jakoai/Riistvara-projekt/components.xlsx

 | link | hind | kogus |  | kokku | 96.39395 | tellitud | 3v3 power max | 0.824717
NFC | https://www.mouser.ee/ProductDetail/STMicroelectronics/ST25DV04KC-IE8T3?qs=QNEnbhJQKvb3R1XQucBykQ%3D%3D | 1.43 | 1 | 1.43 |  |  | 5
GPS | https://www.mouser.ee/ProductDetail/Quectel/L96-M33?qs=GedFDFLaBXHZlDfU1tecmQ%3D%3D | 14.15 | 1 | 14.15 |  |  | 5 | 0.025
IMU | https://www.mouser.ee/ProductDetail/MEMSIC/MC3479 | 1.89 | 1 | 1.89 |  |  | 5 | 7.7e-05
E-ink | https://www.mouser.ee/ProductDetail/Pervasive-Displays/E2266CS0C2?qs=TuK3vfAjtkUnQD9wfVPXWg%3D%3D | 10.98 | 1 | 10.98 |  |  | 5 | 0.00294
ESP32-S3 N16R8 | https://www.mouser.ee/ProductDetail/Espressif-Systems/ESP32-S3-WROOM-1-N16R8 | 4.31 | 1 | 4.31 |  |  | 5 | 0.5
LoRa Ra-01SH | https://www.aliexpress.com/item/4001148156263.html | 4.82 | 1 | 4.82 |  |  | 5 | 0.14
LoRa antenn | https://www.mouser.ee/ProductDetail/Linx-Technologies/ANT-868-HESM?qs=hWgE7mdIu5TTyqPbNERfhg%3D%3D | 1.24 | 1 | 1.24 |  |  | 5
FPC display conn | https://www.mouser.ee/ProductDetail/GCT/FFC2B35-24-T?qs=Li%252BoUPsLEnvLbIbV0OhDVA%3D%3D | 0.47 | 1 | 0.47 |  |  | 5
USB-PD battery | https://www.mouser.ee/ProductDetail/Texas-Instruments/BQ25731RSNR?qs=stqOd1AaK7%2Fv1jry38xYIQ%3D%3D | 3.79 | 1 | 3.79 |  |  | 5
USB-C | https://www.mouser.ee/ProductDetail/TE-Connectivity/2305018-2?qs=EU6FO9ffTwfL23TDwkN0SQ%3D%3D | 2.55 | 2 | 5.1 |  |  | 10 |  |  | https://www.aliexpress.com/item/1005003210911840.html
USB-C protector | https://www.mouser.ee/ProductDetail/Texas-Instruments/TPD6S300ARUKR?qs=%252BEew9%252B0nqrA1G22imPqdyw%3D%3D | 1.3 | 2 | 2.6 |  |  | 10
Buzzer | https://www.mouser.ee/ProductDetail/AATC/AS-1204B-LF?qs=uwxL4vQweFPVV%2FkgmXOg0A%3D%3D | 0.64 | 1 | 0.64 |  |  | 5 | 0.035
SD card holder | https://www.aliexpress.com/item/1005004214252441.html | 0.59 | 1 | 0.59 |  |  | 10 | 0.04
RGB LED | https://www.aliexpress.com/item/32453497583.html | 0.0986 | 12 | 1.1832 |  |  | 100
serial to parralel | https://www.mouser.ee/ProductDetail/Nexperia/74HC595PW-Q100118?qs=1sbE9T7hb3aHrTORCcEuDg%3D%3D | 0.43 | 1 | 0.43 |  |  | 5
parrallel to serial | https://www.mouser.ee/ProductDetail/Texas-Instruments/SN74HCS16507PWR?qs=DPoM0jnrROUIT0uZVZ3kvw%3D%3D | 0.43 | 1 | 0.43 |  |  | 5
USB - UART | https://www.mouser.ee/ProductDetail/Silicon-Labs/CP2102N-A02-GQFN20?qs=u16ybLDytRaG8WdlP0fT2g%3D%3D | 2.16 | 1 | 2.16 |  |  | 5 | 0.0137
USB-PD negotiation | https://www.mouser.ee/ProductDetail/Texas-Instruments/TPS65988DKRSHR?qs=DPoM0jnrROUevQj%2FLwa4Vw%3D%3D | 6.64 | 1 | 6.64 |  |  | 5 | 0.008
DUAL NMOS 35A | https://www.mouser.ee/ProductDetail/Diodes-Incorporated/DMT3006LPB-13?qs=gZXFycFWdAPqLlAKkipM0Q%3D%3D | 0.72 | 2 | 1.44 |  |  | 10
Bat to 5V | https://www.mouser.ee/ProductDetail/Monolithic-Power-Systems-MPS/MP28167GQ-P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 | 3.18 | 1 | 3.18 |  |  | 5
Bat to USB-c | https://www.mouser.ee/ProductDetail/Monolithic-Power-Systems-MPS/MP2229GQ-P?qs=ZNK0BnemlqHKDD1LC56W1w%3D%3D | 2.84 | 2 | 5.68 |  |  | 10
Bat balancer | https://www.mouser.ee/ProductDetail/Texas-Instruments/BQ29209DRBR?qs=hEBn5lgDlCoqdeLwAzko8w%3D%3D | 0.96 | 1 | 0.96 |  |  | 5
Op amp | https://www.mouser.ee/ProductDetail/Texas-Instruments/LM358DR?qs=Zu35EjizYSSY6pJ37yjmHA%3D%3D | 0.37 | 0 | 0
Proximity card | https://www.aliexpress.com/item/33016782798.html | 0.239 | 2 | 0.478 |  |  | 10
Audio connector | https://www.mouser.ee/ProductDetail/CUI-Devices/SJ-3554A-SMT-TR-67?qs=l7cgNqFNU1hER9nK1Mk0ng%3D%3D | 3.45 | 0 | 0
Audio DAC | https://www.mouser.ee/ProductDetail/Texas-Instruments/PCM5100APWR?qs=E2%2FxqS9xjzplp26RZOMMKQ%3D%3D | 2.84 | 0 | 0 |  |  |  | 0.06
DUAL PMOS 6.9A | https://www.mouser.ee/ProductDetail/Diodes-Incorporated/DMP3056LSD-13?qs=oUsD4qhOtFx5gfG3AxMf9Q%3D%3D | 0.75 | 2 | 1.5 |  |  | 10
display schottky | https://www.mouser.ee/ProductDetail/Toshiba/CUHS20S30H3F?qs=PqoDHHvF64%252BnIC9Qnnw9zg%3D%3D | 0.38 | 3 | 1.14 |  |  | 15
nmos 5A | https://www.mouser.ee/ProductDetail/Panjit/PJA3404_R1_00001?qs=sPbYRqrBIVkiUO9ZInE3tw%3D%3D | 0.37 | 6 | 2.22 |  |  | 30
Fuse 20A | https://www.tme.eu/ee/details/zgs-20a/sulavkaitsmed-6-3x32mm-kiired/siba/189000-20/ | 0.2678 | 1 | 0.2678
JST XH 3p | https://www.aliexpress.com/item/1005003559631954.html | 0.0222 | 1 | 0.0222
Fuse holder | https://www.tme.eu/ee/details/01000020z/pcb-kaitsmepesad/littelfuse/ | 0.385 | 2 | 0.77
Resistor 5mO | https://www.mouser.ee/ProductDetail/Vishay/WFCP06125L000FE66?qs=sGAEpiMZZMtlubZbdhIBIJBDgjsVQBFlUYEtiJor9t8%3D | 0.29 | 2 | 0.58 |  |  | 10
Inductor Bat cntr | https://www.mouser.ee/ProductDetail/Bourns/SRP1265C-4R7M?qs=OlC7AqGiEDkg4Xkb2TDlFw%3D%3D | 1.5 | 1 | 1.5 |  |  | 5
Inductor 5V | https://www.mouser.ee/ProductDetail/Walsin/WLPMA0A040M4R7LC?qs=B6kkDfuK7%2FAGhXqtZ1HOFg%3D%3D | 0.67 | 1 | 0.67 |  |  | 5
Inductor USB source | https://www.mouser.ee/ProductDetail/Taiyo-Yuden/NRS8030T1R0NJGJ?qs=PzICbMaShUfBDq1Kfb1D%252Bg%3D%3D | 0.41 | 2 | 0.82 |  |  | 10
Inductor LoRa | https://www.mouser.ee/ProductDetail/Murata-Electronics/LQW18AS11NG00D?qs=Ey7%2FXF42M3d1IHjOIbBX3g%3D%3D | 0.13 | 1 | 0.13 |  |  | 5
Inductor display | https://www.mouser.ee/ProductDetail/Taiyo-Yuden/CBC3225T100KR?qs=I6KAKw0tg2xBtBHDie3dYA%3D%3D | 0.28 | 1 | 0.28 |  |  | 5
Capacitor 10uF | https://www.mouser.ee/ProductDetail/Samsung-Electro-Mechanics/CL31A106MBHNNNE | 0.106 | 26 | 2.756 |  |  | 130
Capacitor 22uF | https://www.mouser.ee/ProductDetail/Wurth-Elektronik/865080542006 | 0.178 | 10 | 1.78 |  |  | 50
Capacitor 33uF | https://www.mouser.ee/ProductDetail/Wurth-Elektronik/865080543008 | 0.273 | 1 | 0.273 |  |  | 15
Resistor 100ohm 2W | https://www.mouser.ee/ProductDetail/Vishay-BC-Components/PR02000201000JR500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 | 0.16 | 2 | 0.32 |  |  | 10
Rubber keypad | https://www.mouser.ee/ProductDetail/474-COM-07835 | 0.355625 | 6 | 2.13375 |  |  | 4
Capacitor 10uF MLCC | https://www.mouser.ee/ProductDetail/81-GRM21BZ71E106KE5L | 0.16 | 13 | 2.08 |  |  | 100
Capacitor 22uF POSCAP | https://www.mouser.ee/ProductDetail/667-25TQC22MYFB | 1.28 | 2 | 2.56 |  |  | 10
