jakoai/Riistvara-projekt/airsoft_controller.kicad_pcb

## KiCad design airsoft_controller.kicad_pcb (2022-11-07)

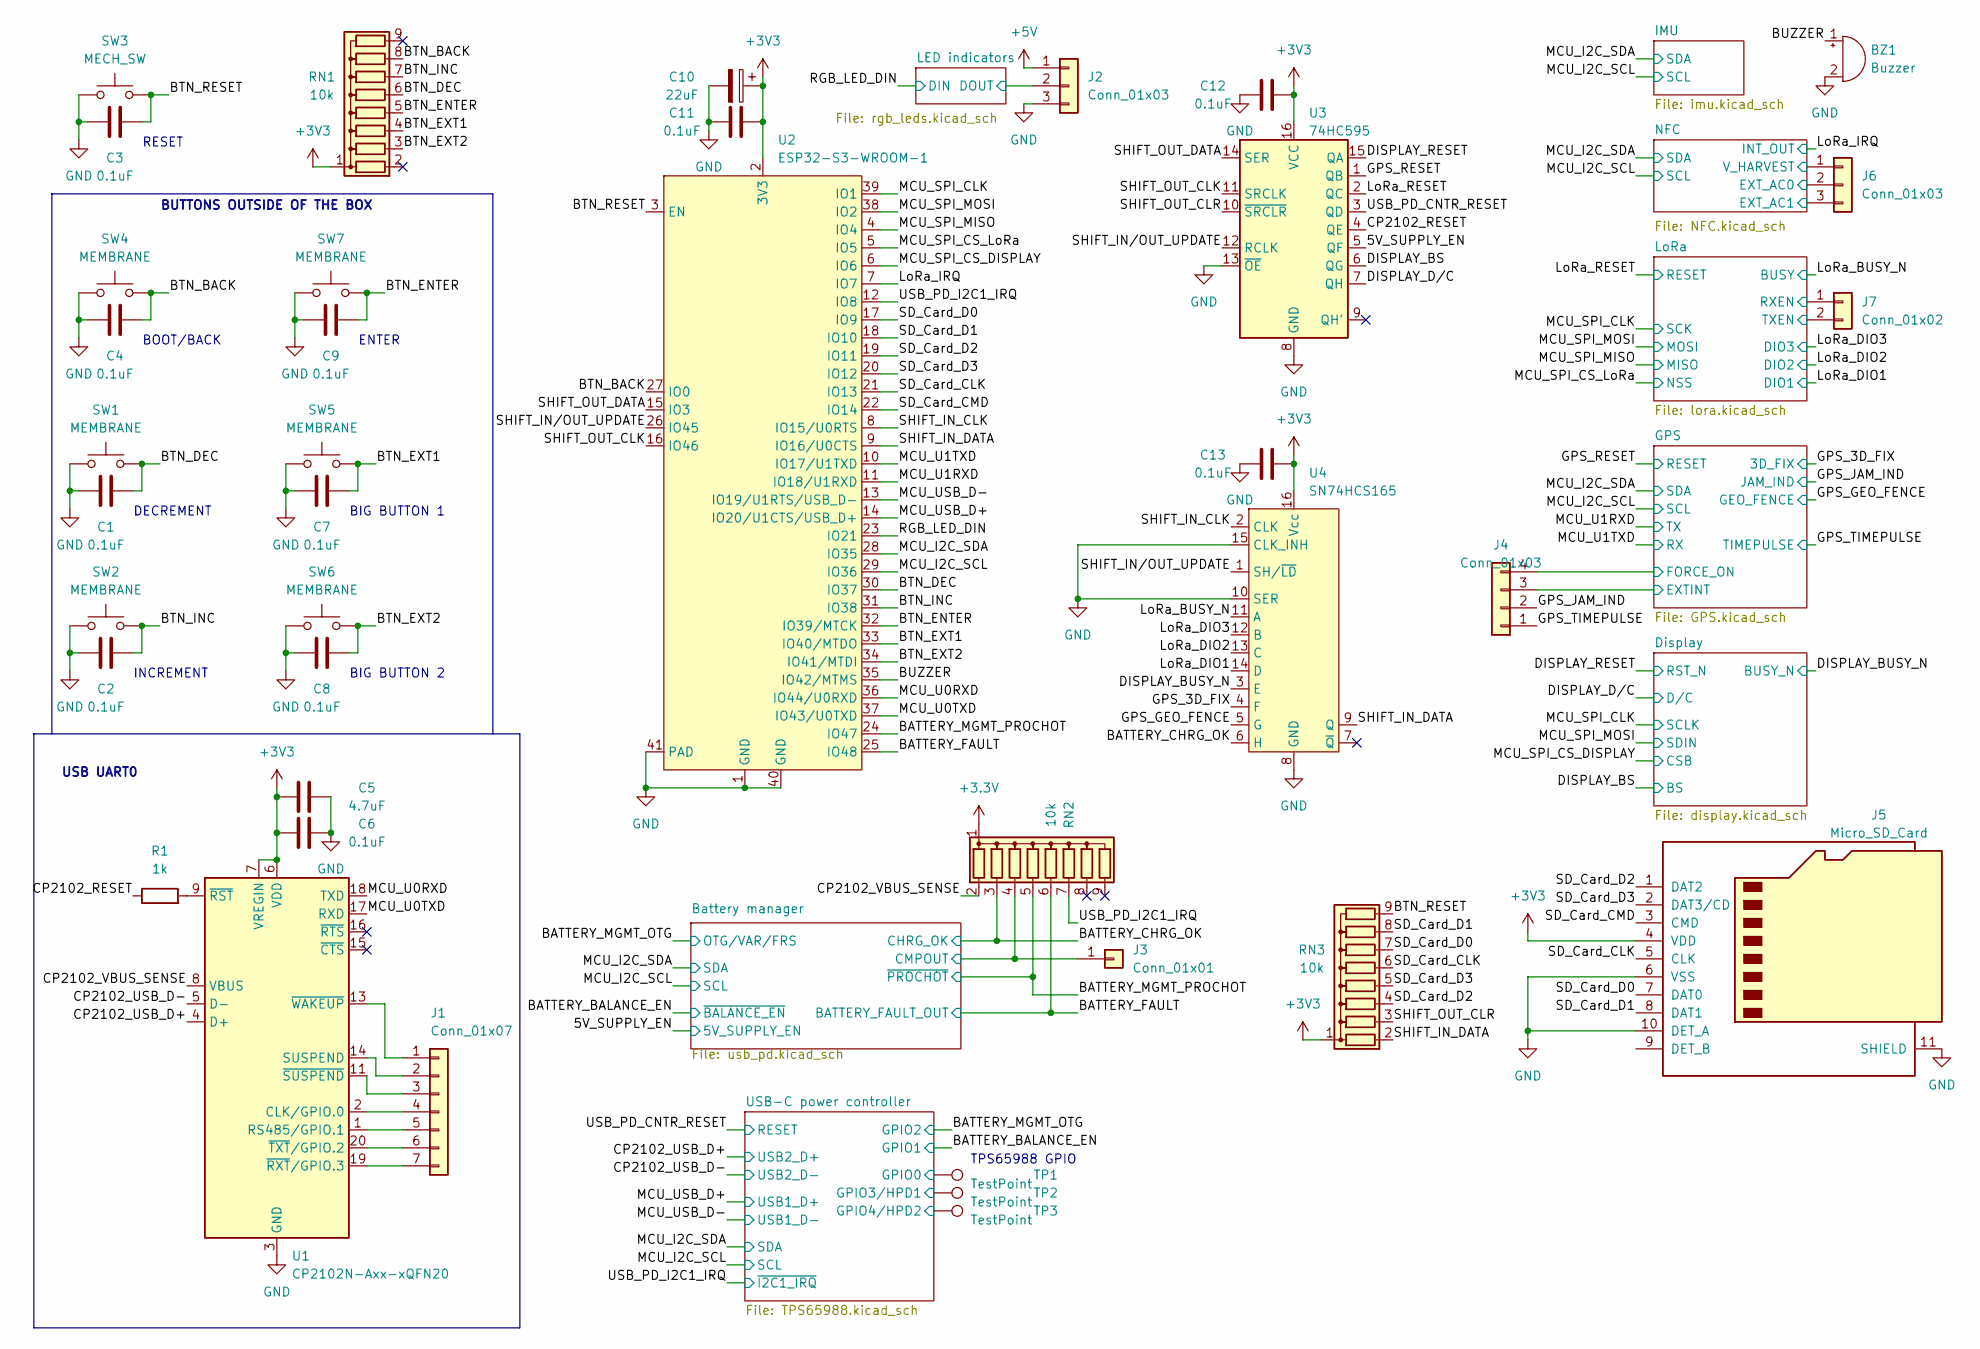
[picture p1: schematic airsoft_controller.kicad_sch]

Parts:
BZ1: Buzzer
C1, C2, C3, C4, C6, C7, C8, C9, C11, C12, C13: 0.1uF; C_0603_1608Metric_Pad1.08x0.95mm_HandSolder
C5: 4.7uF; C_0603_1608Metric_Pad1.08x0.95mm_HandSolder
C10: 22uF; CP_Elec_5x5.3
J1: Conn_01x07; PinSocket_1x07_P2.54mm_Vertical
J2, J6: Conn_01x03; PinSocket_1x03_P2.54mm_Vertical
J3: Conn_01x01; PinSocket_1x01_P2.54mm_Vertical
J4: Conn_01x03; PinSocket_1x04_P2.54mm_Vertical
J5: Micro_SD_Card; microSD-W3JA7HH800293
J7: Conn_01x02; PinSocket_1x02_P2.54mm_Vertical
R1: 1k; R_0603_1608Metric_Pad0.98x0.95mm_HandSolder
RN1, RN2, RN3: 10k; R_Array_SIP9
SW1, SW2, SW4, SW5, SW6, SW7: MEMBRANE; SW_rubber_membrane_for_led
SW3: MECH_SW; SWITCH_TL3315NF250Q
TP1, TP2, TP3: TestPoint; TestPoint_Pad_D1.5mm
U1: CP2102N-Axx-xQFN20; SiliconLabs_QFN-20-1EP_3x3mm_P0.5mm_EP1.8x1.8mm
U2: ESP32-S3-WROOM-1; ESP32­S3­WROOM­1
U3: 74HC595; TSSOP-16_4.4x5mm_P0.65mm
U4: SN74HCS165; TSSOP-16_4.4x5mm_P0.65mm

Connections:
+3V3: C5.1, C6.1, C10.1, C11.2, C12.2, C13.2, J5.4 (VDD), RN1.1 (common), RN3.1 (common), U1.6 (VDD), U1.7 (VREGIN), U2.2 (3V3), U3.16 (VCC), U4.16 (Vcc); also elsewhere on the board
+5V: J2.1; also elsewhere on the board
/5V_SUPPLY_EN: U3.5 (QF); also elsewhere on the board
/BATTERY_CHRG_OK: RN2.3 (R2), U4.6 (H); also elsewhere on the board
/BATTERY_FAULT: RN2.6 (R5), U2.25 (IO48); also elsewhere on the board
/BATTERY_MGMT_PROCHOT: RN2.5 (R4), U2.24 (IO47); also elsewhere on the board
/BTN_BACK: C4.1, RN1.8 (R7), SW4.2, U2.27 (IO0)
/BTN_DEC: C1.1, RN1.6 (R5), SW1.2, U2.30 (IO37)
/BTN_ENTER: C9.1, RN1.5 (R4), SW7.2, U2.32 (IO39/MTCK)
/BTN_EXT1: C7.1, RN1.4 (R3), SW5.2, U2.33 (IO40/MTDO)
/BTN_EXT2: C8.1, RN1.3 (R2), SW6.2, U2.34 (IO41/MTDI)
/BTN_INC: C2.1, RN1.7 (R6), SW2.2, U2.31 (IO38)
/BTN_RESET: C3.1, RN3.9 (R8), SW3.3 (B), SW3.4 (B), U2.3 (EN)
/BUZZER: BZ1.1 (-), U2.35 (IO42/MTMS)
/Battery manager/CMPOUT: J3.1, RN2.4 (R3); also elsewhere on the board
/CP2102_RESET: R1.1, U3.4 (QE)
/CP2102_USB_D+: U1.4 (D+); also elsewhere on the board
/CP2102_USB_D-: U1.5 (D-); also elsewhere on the board
/CP2102_VBUS_SENSE: RN2.2 (R1), U1.8 (VBUS)
/DISPLAY_BS: U3.6 (QG); also elsewhere on the board
/DISPLAY_BUSY_N: U4.3 (E); also elsewhere on the board
/DISPLAY_D/C: U3.7 (QH); also elsewhere on the board
/DISPLAY_RESET: U3.15 (QA); also elsewhere on the board
/GPS/EXTINT: J4.3; also elsewhere on the board
/GPS/FORCE_ON: J4.4; also elsewhere on the board
/GPS_3D_FIX: U4.4 (F); also elsewhere on the board
/GPS_GEO_FENCE: U4.5 (G); also elsewhere on the board
/GPS_JAM_IND: J4.2; also elsewhere on the board
/GPS_RESET: U3.1 (QB); also elsewhere on the board
/GPS_TIMEPULSE: J4.1; also elsewhere on the board
/LED indicators/DOUT: J2.2; also elsewhere on the board
/LoRa/RXEN: J7.1; also elsewhere on the board
/LoRa/TXEN: J7.2; also elsewhere on the board
/LoRa_BUSY_N: U4.11 (A); also elsewhere on the board
/LoRa_DIO1: U4.14 (D); also elsewhere on the board
/LoRa_DIO2: U4.13 (C); also elsewhere on the board
/LoRa_DIO3: U4.12 (B); also elsewhere on the board
/LoRa_IRQ: U2.7 (IO7); also elsewhere on the board
/LoRa_RESET: U3.2 (QC); also elsewhere on the board
/MCU_I2C_SCL: U2.29 (IO36); also elsewhere on the board
/MCU_I2C_SDA: U2.28 (IO35); also elsewhere on the board
/MCU_SPI_CLK: U2.39 (IO1); also elsewhere on the board
/MCU_SPI_CS_DISPLAY: U2.6 (IO6); also elsewhere on the board
/MCU_SPI_CS_LoRa: U2.5 (IO5); also elsewhere on the board
/MCU_SPI_MISO: U2.4 (IO4); also elsewhere on the board
/MCU_SPI_MOSI: U2.38 (IO2); also elsewhere on the board
/MCU_U0RXD: U1.18 (TXD), U2.36 (IO44/U0RXD)
/MCU_U0TXD: U1.17 (RXD), U2.37 (IO43/U0TXD)
/MCU_U1RXD: U2.11 (IO18/U1RXD); also elsewhere on the board
/MCU_U1TXD: U2.10 (IO17/U1TXD); also elsewhere on the board
/MCU_USB_D+: U2.14 (IO20/U1CTS/USB_D+); also elsewhere on the board
/MCU_USB_D-: U2.13 (IO19/U1RTS/USB_D-); also elsewhere on the board
/NFC/EXT_AC0: J6.2; also elsewhere on the board
/NFC/EXT_AC1: J6.3; also elsewhere on the board
/NFC/V_HARVEST: J6.1; also elsewhere on the board
/RGB_LED_DIN: U2.23 (IO21); also elsewhere on the board
/SD_Card_CLK: J5.5 (CLK), RN3.6 (R5), U2.21 (IO13)
/SD_Card_CMD: J5.3 (CMD), U2.22 (IO14)
/SD_Card_D0: J5.7 (DAT0), RN3.7 (R6), U2.17 (IO9)
/SD_Card_D1: J5.8 (DAT1), RN3.8 (R7), U2.18 (IO10)
/SD_Card_D2: J5.1 (DAT2), RN3.4 (R3), U2.19 (IO11)
/SD_Card_D3: J5.2 (DAT3/CD), RN3.5 (R4), U2.20 (IO12)
/SHIFT_IN_CLK: U2.8 (IO15/U0RTS), U4.2 (CLK)
/SHIFT_IN_DATA: RN3.2 (R1), U2.9 (IO16/U0CTS), U4.9 (Q)
/SHIFT_IN/OUT_UPDATE: U2.26 (IO45), U3.12 (RCLK), U4.1 (SH/~LD)
/SHIFT_OUT_CLK: U2.16 (IO46), U3.11 (SRCLK)
/SHIFT_OUT_CLR: RN3.3 (R2), U3.10 (~SRCLR)
/SHIFT_OUT_DATA: U2.15 (IO3), U3.14 (SER)
/USB-C power controller/GPIO0: TP1.1; also elsewhere on the board
/USB-C power controller/GPIO3/HPD1: TP2.1; also elsewhere on the board
/USB-C power controller/GPIO4/HPD2: TP3.1; also elsewhere on the board
/USB_PD_CNTR_RESET: U3.3 (QD); also elsewhere on the board
/USB_PD_I2C1_IRQ: RN2.7 (R6), U2.12 (IO8); also elsewhere on the board
GND: BZ1.2 (+), C1.2, C2.2, C3.2, C4.2, C5.2, C6.2, C7.2, C8.2, C9.2, C10.2, C11.1, C12.1, C13.1, J2.3, J5.6 (VSS), J5.10 (DET_A), J5.11 (SHIELD), SW1.1, SW2.1, SW3.1 (A), SW3.2 (A), SW4.1, SW5.1, SW6.1, SW7.1, U1.3 (GND), U1.12 (GND), U1.21 (GND), U2.1 (GND), U2.40 (GND), U2.41 (PAD), U3.8 (GND), U3.13 (~OE), U4.8 (GND), U4.10 (SER), U4.15 (CLK_INH); also elsewhere on the board
unnamed: J1.1, U1.13 (~WAKEUP)
unnamed: J1.2, U1.14 (SUSPEND)
unnamed: J1.3, U1.11 (~SUSPEND)
unnamed: J1.4, U1.2 (CLK/GPIO.0)
unnamed: J1.5, U1.1 (RS485/GPIO.1)
unnamed: J1.6, U1.20 (~TXT/GPIO.2)
unnamed: J1.7, U1.19 (~RXT/GPIO.3)
unnamed: R1.2, U1.9 (~RST)

Notes on the sheet:
BOOT/BACK
ENTER
USB UART0
RESET
DECREMENT
INCREMENT
TPS65988 GPIO
BIG BUTTON 1
BUTTONS OUTSIDE OF THE BOX
BIG BUTTON 2

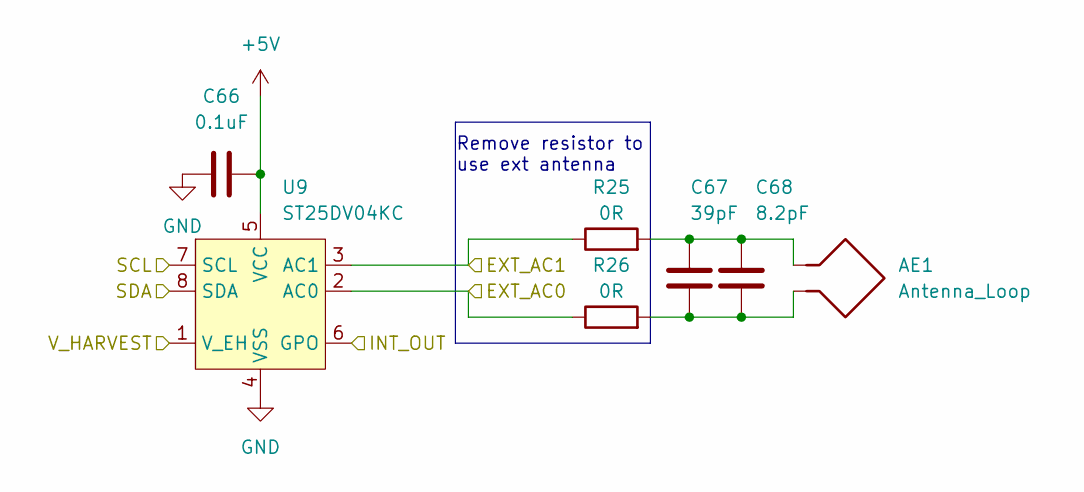
[picture p2: schematic NFC.kicad_sch]

Parts:
AE1: Antenna_Loop; Antenna_loop-13.56MHz
C66: 0.1uF; C_0603_1608Metric_Pad1.08x0.95mm_HandSolder
C67: 39pF; C_0603_1608Metric_Pad1.08x0.95mm_HandSolder
C68: 8.2pF; C_0603_1608Metric_Pad1.08x0.95mm_HandSolder
R25, R26: 0R; R_0603_1608Metric_Pad0.98x0.95mm_HandSolder
U9: ST25DV04KC; TSSOP-8_6.4x3mm_P0.65mm

Connections:
+5V: C66.2, U9.5 (VCC); also elsewhere on the board
/LoRa_IRQ: U9.6 (GPO); also elsewhere on the board
/MCU_I2C_SCL: U9.7 (SCL); also elsewhere on the board
/MCU_I2C_SDA: U9.8 (SDA); also elsewhere on the board
/NFC/EXT_AC0: R26.1, U9.2 (AC0); also elsewhere on the board
/NFC/EXT_AC1: R25.1, U9.3 (AC1); also elsewhere on the board
/NFC/V_HARVEST: U9.1 (V_EH); also elsewhere on the board
GND: C66.1, U9.4 (VSS); also elsewhere on the board
unnamed: AE1.1, C67.1, C68.1, R25.2
unnamed: AE1.2, C67.2, C68.2, R26.2

Notes on the sheet:
Remove resistor to use ext antenna

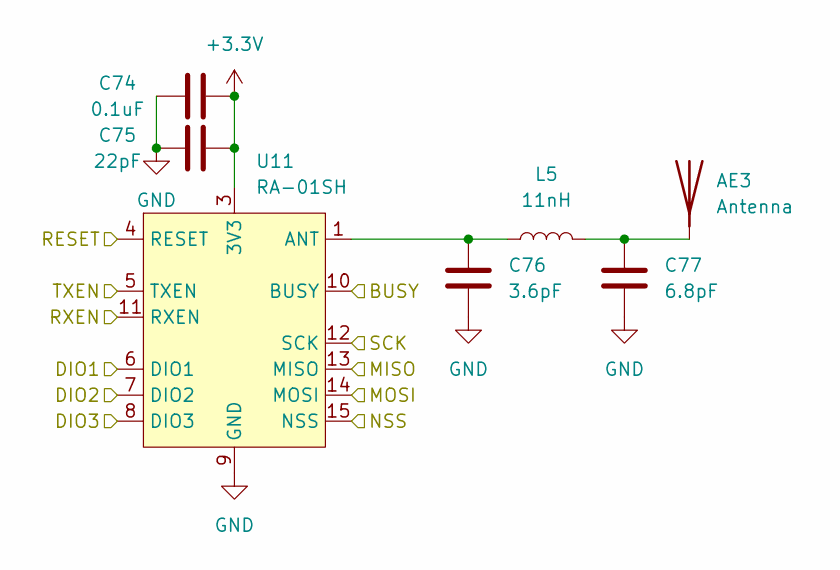
[picture p3: schematic lora.kicad_sch]

Parts:
AE3: Antenna; LoRa-antenna-868-HESM
C74: 0.1uF; C_0603_1608Metric_Pad1.08x0.95mm_HandSolder
C75: 22pF; C_0603_1608Metric_Pad1.08x0.95mm_HandSolder
C76: 3.6pF; C_0603_1608Metric_Pad1.08x0.95mm_HandSolder
C77: 6.8pF; C_0603_1608Metric_Pad1.08x0.95mm_HandSolder
L5: 11nH; L_0603_1608Metric_Pad1.05x0.95mm_HandSolder
U11: RA-01SH

Connections:
/LoRa/RXEN: U11.11 (RXEN); also elsewhere on the board
/LoRa/TXEN: U11.5 (TXEN); also elsewhere on the board
/LoRa_BUSY_N: U11.10 (BUSY); also elsewhere on the board
/LoRa_DIO1: U11.6 (DIO1); also elsewhere on the board
/LoRa_DIO2: U11.7 (DIO2); also elsewhere on the board
/LoRa_DIO3: U11.8 (DIO3); also elsewhere on the board
/LoRa_RESET: U11.4 (RESET); also elsewhere on the board
/MCU_SPI_CLK: U11.12 (SCK); also elsewhere on the board
/MCU_SPI_CS_LoRa: U11.15 (NSS); also elsewhere on the board
/MCU_SPI_MISO: U11.13 (MISO); also elsewhere on the board
/MCU_SPI_MOSI: U11.14 (MOSI); also elsewhere on the board
GND: C74.1, C75.1, C76.2, C77.2, U11.2 (GND), U11.9 (GND), U11.16 (GND); also elsewhere on the board
unnamed: AE3.1 (A), C77.1, L5.2
unnamed: C76.1, L5.1, U11.1 (ANT)

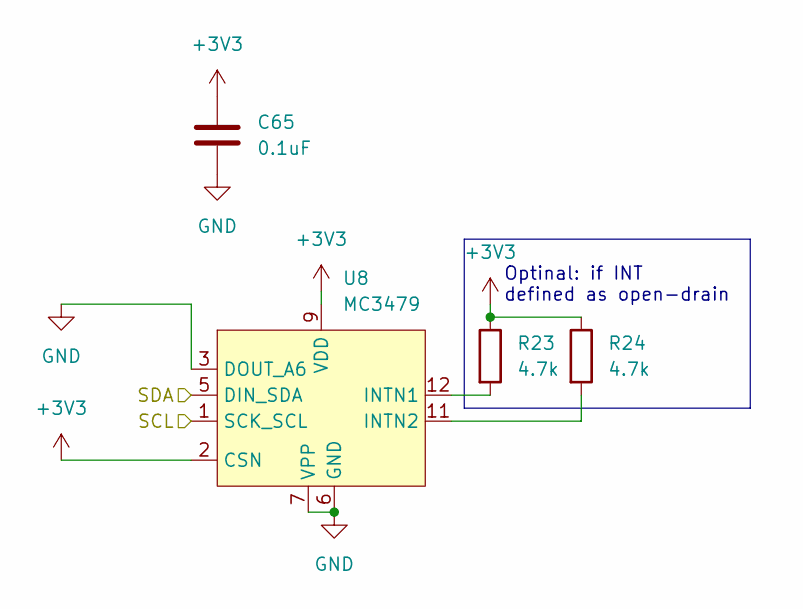
[picture p4: schematic imu.kicad_sch]

Parts:
C65: 0.1uF; C_0603_1608Metric_Pad1.08x0.95mm_HandSolder
R23, R24: 4.7k; R_0603_1608Metric_Pad0.98x0.95mm_HandSolder
U8: MC3479; LGA-12_2x2mm_P0.5mm

Connections:
+3V3: C65.2, R23.1, R24.1, U8.2 (CSN), U8.9 (VDD); also elsewhere on the board
/MCU_I2C_SCL: U8.1 (SCK_SCL); also elsewhere on the board
/MCU_I2C_SDA: U8.5 (DIN_SDA); also elsewhere on the board
GND: C65.1, U8.3 (DOUT_A6), U8.6 (GND), U8.7 (VPP); also elsewhere on the board
unnamed: R23.2, U8.12 (INTN1)
unnamed: R24.2, U8.11 (INTN2)

Notes on the sheet:
Optinal: if INT defined as open-drain

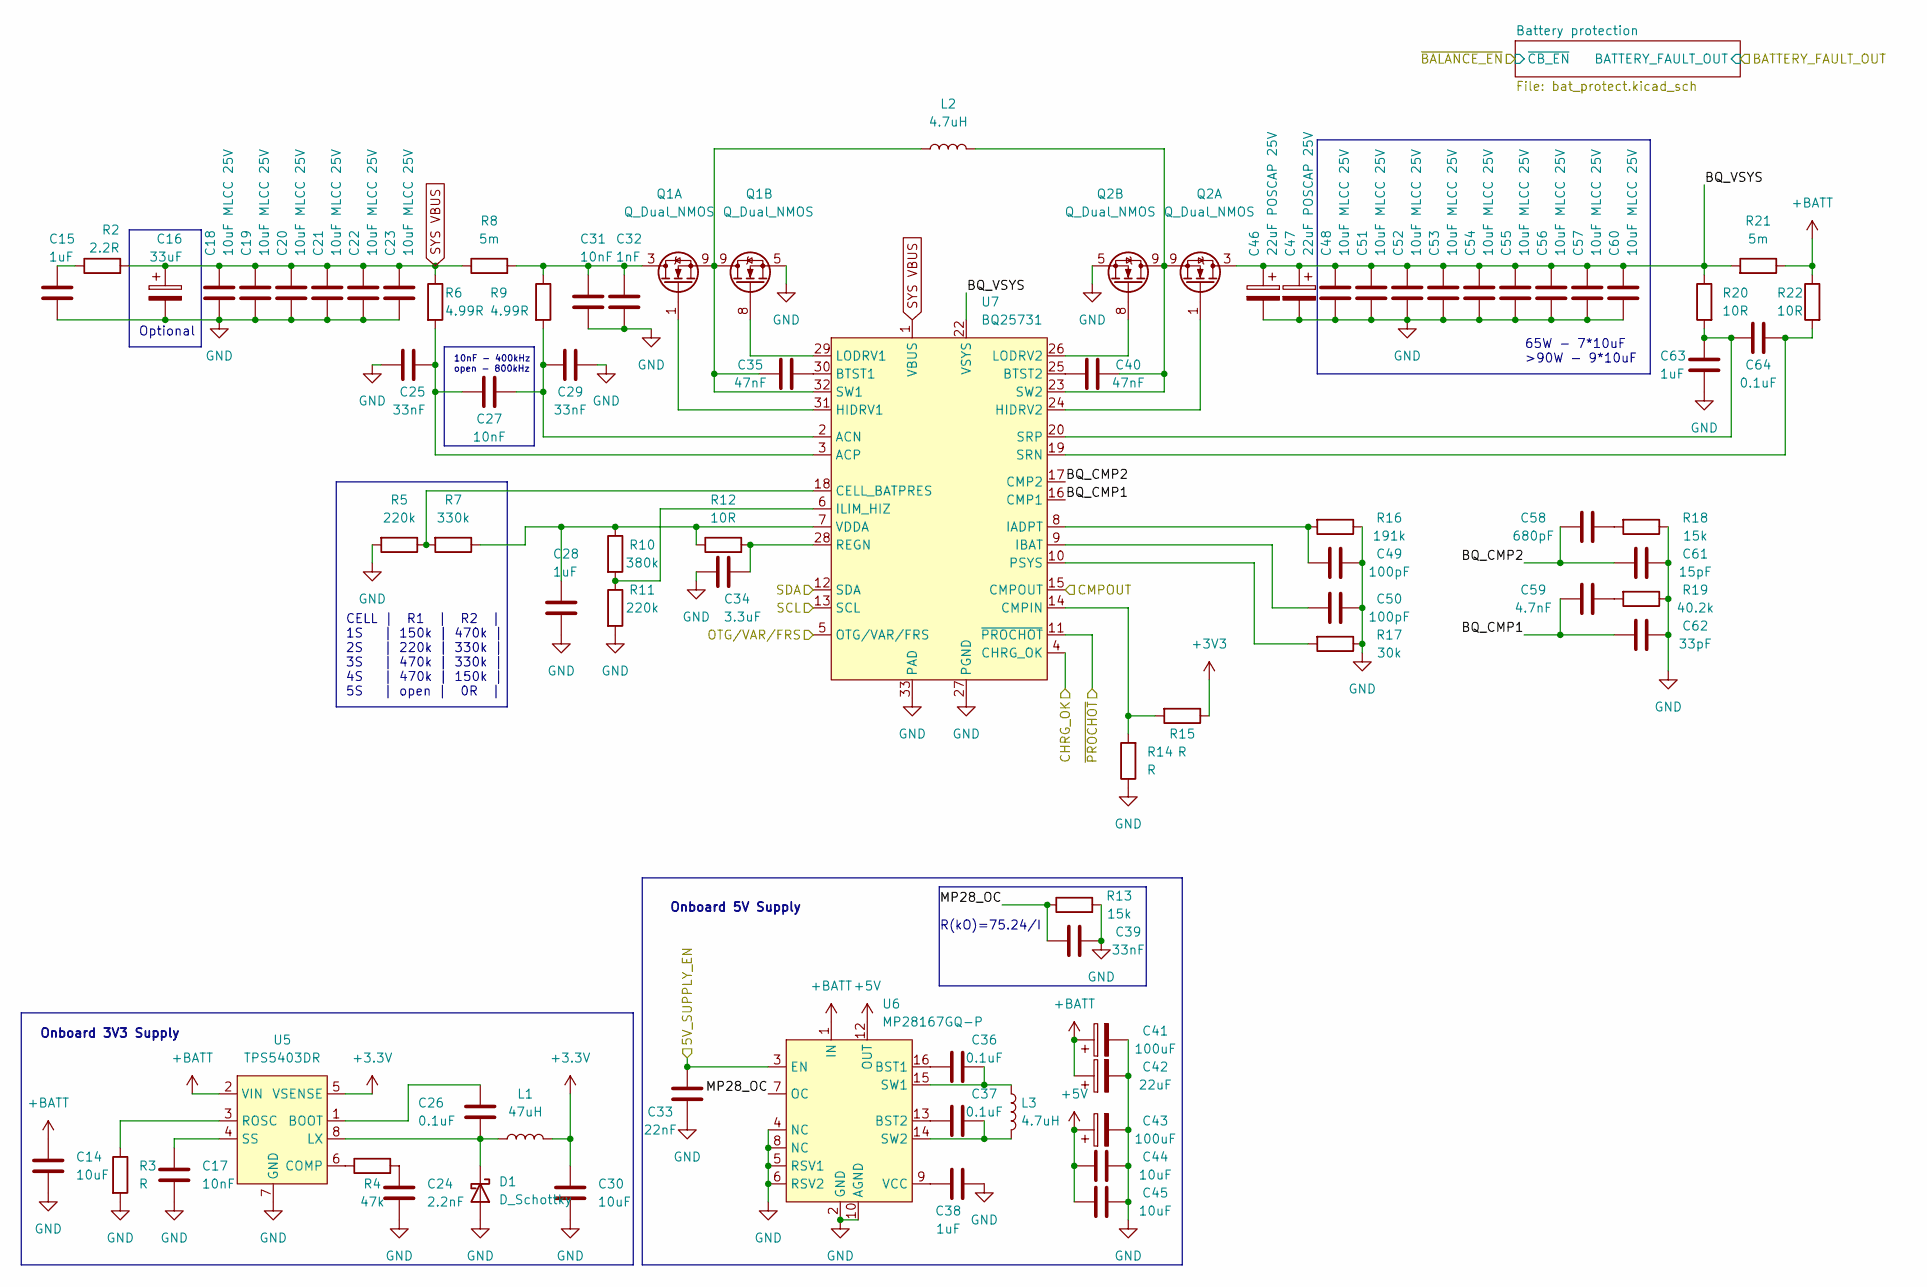
[picture p5: schematic usb_pd.kicad_sch]

Parts:
C14, C44, C45: 10uF; C_0805_2012Metric_Pad1.18x1.45mm_HandSolder
C15, C28, C38, C63: 1uF; C_0603_1608Metric_Pad1.08x0.95mm_HandSolder
C16: 33uF; CP_Elec_6.3x5.4
C17, C27, C31: 10nF; C_0603_1608Metric_Pad1.08x0.95mm_HandSolder
C18, C19, C20, C21, C22, C23, C51, C52, C53, C54, C55, C56, C57, C60: 10uF MLCC 25V; C_0805_2012Metric_Pad1.18x1.45mm_HandSolder
C24: 2.2nF; C_0603_1608Metric_Pad1.08x0.95mm_HandSolder
C25, C29, C39: 33nF; C_0603_1608Metric_Pad1.08x0.95mm_HandSolder
C26, C36, C37, C64: 0.1uF; C_0603_1608Metric_Pad1.08x0.95mm_HandSolder
C30: 10uF; C_1206_3216Metric_Pad1.33x1.80mm_HandSolder
C32: 1nF; C_0603_1608Metric_Pad1.08x0.95mm_HandSolder
C33: 22nF; C_0603_1608Metric_Pad1.08x0.95mm_HandSolder
C34: 3.3uF; C_0603_1608Metric_Pad1.08x0.95mm_HandSolder
C35, C40: 47nF; C_0603_1608Metric_Pad1.08x0.95mm_HandSolder
C41, C43: 100uF; CP_Elec_6.3x7.7
C42: 22uF; CP_Elec_5x5.3
C46, C47: 22uF POSCAP 25V; C_1210_3225Metric_Pad1.33x2.70mm_HandSolder
C48: 10uF MLCC 25V; C_1206_3216Metric_Pad1.33x1.80mm_HandSolder
C49, C50: 100pF; C_0603_1608Metric_Pad1.08x0.95mm_HandSolder
C58: 680pF; C_0603_1608Metric_Pad1.08x0.95mm_HandSolder
C59: 4.7nF; C_0603_1608Metric_Pad1.08x0.95mm_HandSolder
C61: 15pF; C_0603_1608Metric_Pad1.08x0.95mm_HandSolder
C62: 33pF; C_0603_1608Metric_Pad1.08x0.95mm_HandSolder
D1: D_Schottky; D_SMB
L1: 47uH; Inductor_104CDMCC
L2: 4.7uH; Inductor_SRP1265C
L3: 4.7uH; Inductor_WLPMA0A040
Q1, Q2: Q_Dual_NMOS; Q_DUAL_NMOS_DMT3006LPB
R2: 2.2R; R_0603_1608Metric_Pad0.98x0.95mm_HandSolder
R3, R14, R15: R; R_0603_1608Metric_Pad0.98x0.95mm_HandSolder
R4: 47k; R_0603_1608Metric_Pad0.98x0.95mm_HandSolder
R5, R11: 220k; R_0603_1608Metric_Pad0.98x0.95mm_HandSolder
R6, R9: 4.99R; R_0603_1608Metric_Pad0.98x0.95mm_HandSolder
R7: 330k; R_0603_1608Metric_Pad0.98x0.95mm_HandSolder
R8, R21: 5m; R_0612_1632Metric_Pad1.18x3.40mm_HandSolder
R10: 380k; R_0603_1608Metric_Pad0.98x0.95mm_HandSolder
R12, R20, R22: 10R; R_0603_1608Metric_Pad0.98x0.95mm_HandSolder
R13, R18: 15k; R_0603_1608Metric_Pad0.98x0.95mm_HandSolder
R16: 191k; R_0603_1608Metric_Pad0.98x0.95mm_HandSolder
R17: 30k; R_0603_1608Metric_Pad0.98x0.95mm_HandSolder
R19: 40.2k; R_0603_1608Metric_Pad0.98x0.95mm_HandSolder
U5: TPS5403DR; SOIC-8_3.9x4.9mm_P1.27mm
U6: MP28167GQ-P; QFN-16
U7: BQ25731; Texas_S-PWQFN-N32_EP2.8x2.8mm

Connections:
+5V: C43.1, C44.1, C45.1, U6.12 (OUT); also elsewhere on the board
+BATT: C14.2, C41.1, C42.1, R21.1, R22.1, U5.2 (VIN), U6.1 (IN); also elsewhere on the board
/5V_SUPPLY_EN: C33.2, U6.3 (EN); also elsewhere on the board
/BATTERY_CHRG_OK: U7.4 (CHRG_OK); also elsewhere on the board
/BATTERY_MGMT_OTG: U7.5 (OTG/VAR/FRS); also elsewhere on the board
/BATTERY_MGMT_PROCHOT: U7.11 (~PROCHOT); also elsewhere on the board
/Battery manager/BQ_CMP1: C59.1, C62.1, U7.16 (CMP1)
/Battery manager/BQ_CMP2: C58.1, C61.1, U7.17 (CMP2)
/Battery manager/BQ_VSYS: C46.1, C47.1, C48.2, C51.2, C52.2, C53.2, C54.2, C55.2, C56.2, C57.2, C60.2, Q2.2 (D1), Q2.3 (D1), Q2.4 (D1), R20.1, R21.2, U7.22 (VSYS)
/Battery manager/CMPOUT: U7.15 (CMPOUT); also elsewhere on the board
/Battery manager/MP28_OC: C39.1, R13.1, U6.7 (OC)
/MCU_I2C_SCL: U7.13 (SCL); also elsewhere on the board
/MCU_I2C_SDA: U7.12 (SDA); also elsewhere on the board
GND: C14.1, C15.1, C16.2, C17.2, C18.1, C19.1, C20.1, C21.1, C22.1, C23.1, C24.2, C25.2, C28.1, C29.2, C30.1, C31.1, C32.1, C33.1, C34.1, C38.2, C39.2, C41.2, C42.2, C43.2, C44.2, C45.2, C46.2, C47.2, C48.1, C49.2, C50.1, C51.1, C52.1, C53.1, C54.1, C55.1, C56.1, C57.1, C60.1, C61.2, C62.2, C63.2, D1.2 (A), Q1.5 (S2), Q1.6 (S2), Q1.7 (S2), Q2.5 (S2), Q2.6 (S2), Q2.7 (S2), R3.2, R5.2, R11.2, R13.2, R14.1, R16.1, R17.1, R18.1, R19.1, U5.7 (GND), U6.2 (GND), U6.4 (NC), U6.5 (RSV1), U6.6 (RSV2), U6.8 (NC), U6.10 (AGND), U6.11 (GND), U7.27 (PGND), U7.33 (PAD); also elsewhere on the board
unnamed: C15.2, R2.1
unnamed: C17.1, U5.4 (SS)
unnamed: C24.1, R4.2
unnamed: C25.1, C27.1, R6.2, U7.3 (ACP)
unnamed: C26.1, U5.1 (BOOT)
unnamed: C26.2, D1.1 (K), L1.1, U5.8 (LX)
unnamed: C27.2, C29.1, R9.2, U7.2 (ACN)
unnamed: C28.2, R7.1, R10.1, R12.1, U7.7 (VDDA)
unnamed: C31.2, C32.2, Q1.2 (D1), Q1.3 (D1), Q1.4 (D1), R8.2, R9.1
unnamed: C34.2, R12.2, U7.28 (REGN)
unnamed: C35.1, U7.30 (BTST1)
unnamed: C35.2, L2.1, Q1.9 (S1/D2), U7.32 (SW1)
unnamed: C36.1, U6.16 (BST1)
unnamed: C36.2, L3.1, U6.15 (SW1)
unnamed: C37.1, U6.13 (BST2)
unnamed: C37.2, L3.2, U6.14 (SW2)
unnamed: C38.1, U6.9 (VCC)
unnamed: C40.1, U7.25 (BTST2)
unnamed: C40.2, L2.2, Q2.9 (S1/D2), U7.23 (SW2)
unnamed: C49.1, R16.2, U7.8 (IADPT)
unnamed: C50.2, U7.9 (IBAT)
unnamed: C58.2, R18.2
unnamed: C59.2, R19.2
unnamed: C63.1, C64.2, R20.2, U7.20 (SRP)
unnamed: C64.1, R22.2, U7.19 (SRN)
unnamed: Q1.1 (G1), U7.31 (HIDRV1)
unnamed: Q1.8 (G2), U7.29 (LODRV1)
unnamed: Q2.1 (G1), U7.24 (HIDRV2)
unnamed: Q2.8 (G2), U7.26 (LODRV2)
unnamed: R3.1, U5.3 (ROSC)
unnamed: R4.1, U5.6 (COMP)
unnamed: R5.1, R7.2, U7.18 (CELL_BATPRES)
unnamed: R10.2, R11.1, U7.6 (ILIM_HIZ)
unnamed: R14.2, R15.2, U7.14 (CMPIN)
unnamed: R17.2, U7.10 (PSYS)
SYS VBUS: C16.1, C18.2, C19.2, C20.2, C21.2, C22.2, C23.2, R2.2, R6.1, R8.1, U7.1 (VBUS); also elsewhere on the board

Notes on the sheet:
65W - 7*10uF >90W - 9*10uF
CELL | R1 | R2 | 1S | 150k | 470k | 2S | 220k | 330k | 3S | 470k | 330k | 4S | 470k | 150k | 5S | open | 0R |
R(kO)=75.24/I
Onboard 3V3 Supply
Optional
10nF - 400kHz open - 800kHz
Onboard 5V Supply

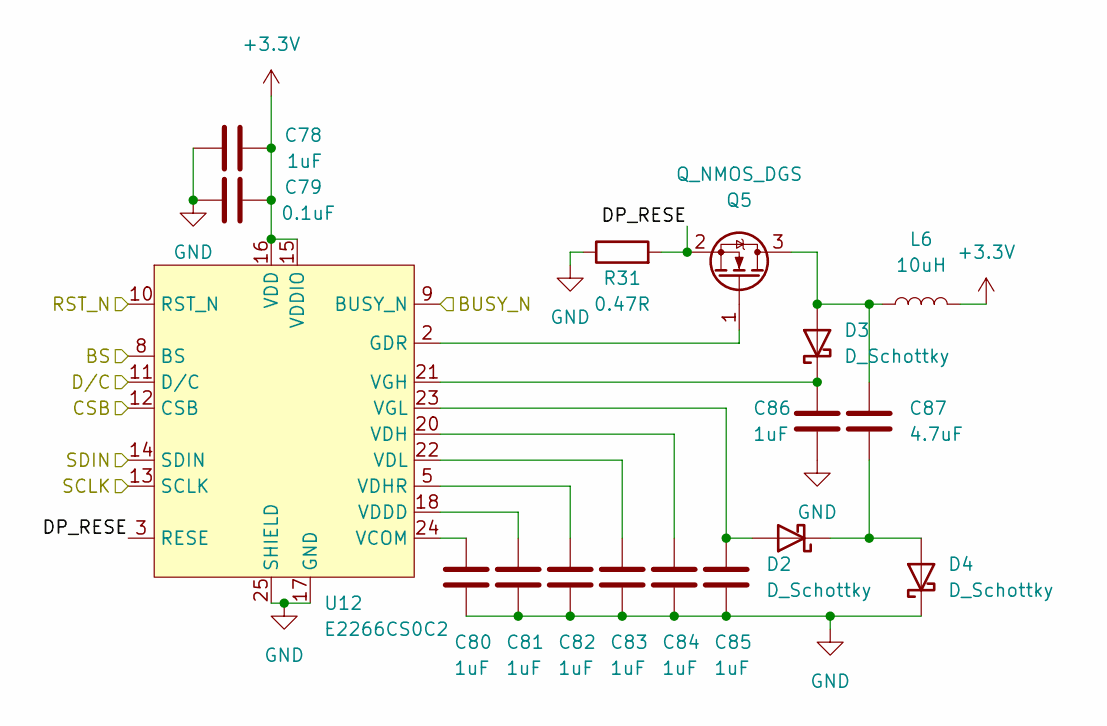
[picture p6: schematic display.kicad_sch]

Parts:
C78, C80, C81, C82, C83, C84, C85, C86: 1uF; C_0603_1608Metric_Pad1.08x0.95mm_HandSolder
C79: 0.1uF; C_0603_1608Metric_Pad1.08x0.95mm_HandSolder
C87: 4.7uF; C_0603_1608Metric_Pad1.08x0.95mm_HandSolder
D2, D3, D4: D_Schottky; D-US2H-2
L6: 10uH; L_1210_3225Metric_Pad1.42x2.65mm_HandSolder
Q5: Q_NMOS_DGS; SOT-23
R31: 0.47R; R_0603_1608Metric_Pad0.98x0.95mm_HandSolder
U12: E2266CS0C2; FPC-24p-0.5

Connections:
/DISPLAY_BS: U12.8 (BS); also elsewhere on the board
/DISPLAY_BUSY_N: U12.9 (BUSY_N); also elsewhere on the board
/DISPLAY_D/C: U12.11 (D/C); also elsewhere on the board
/DISPLAY_RESET: U12.10 (RST_N); also elsewhere on the board
/Display/DP_RESE: Q5.2 (S), R31.2, U12.3 (RESE)
/MCU_SPI_CLK: U12.13 (SCLK); also elsewhere on the board
/MCU_SPI_CS_DISPLAY: U12.12 (CSB); also elsewhere on the board
/MCU_SPI_MOSI: U12.14 (SDIN); also elsewhere on the board
GND: C78.2, C79.2, C80.1, C81.1, C82.1, C83.1, C84.1, C85.1, C86.1, D4.1 (K), R31.1, U12.17 (GND), U12.25 (SHIELD), U12.26 (SHIELD); also elsewhere on the board
unnamed: C80.2, U12.24 (VCOM)
unnamed: C81.2, U12.18 (VDDD)
unnamed: C82.2, U12.5 (VDHR)
unnamed: C83.2, U12.22 (VDL)
unnamed: C84.2, U12.20 (VDH)
unnamed: C85.2, D2.2 (A), U12.23 (VGL)
unnamed: C86.2, D3.1 (K), U12.21 (VGH)
unnamed: C87.1, D2.1 (K), D4.2 (A)
unnamed: C87.2, D3.2 (A), L6.1, Q5.3 (D)
unnamed: Q5.1 (G), U12.2 (GDR)

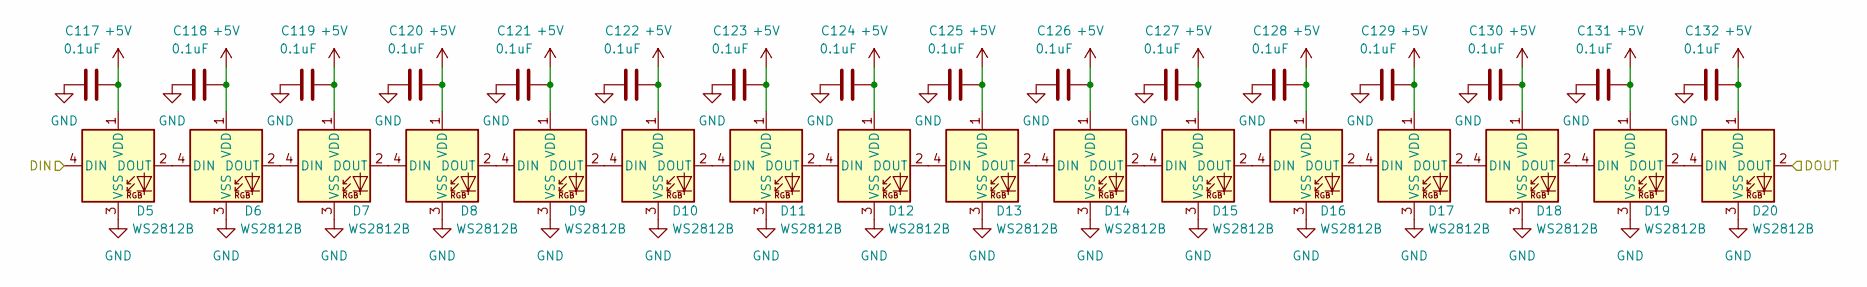
[picture p7: schematic rgb_leds.kicad_sch]

Parts:
C117, C118, C119, C120, C121, C122, C123, C124, C125, C126, C127, C128, C129, C130, C131, C132: 0.1uF; C_0603_1608Metric_Pad1.08x0.95mm_HandSolder
D5, D6, D7, D8, D9, D10, D11, D12, D13, D14, D15, D16, D17, D18, D19, D20: WS2812B; LED_WS2812B_PLCC4_5.0x5.0mm_P3.2mm

Connections:
+5V: C117.2, C118.2, C119.2, C120.2, C121.2, C122.2, C123.2, C124.2, C125.2, C126.2, C127.2, C128.2, C129.2, C130.2, C131.2, C132.2, D5.1 (VDD), D6.1 (VDD), D7.1 (VDD), D8.1 (VDD), D9.1 (VDD), D10.1 (VDD), D11.1 (VDD), D12.1 (VDD), D13.1 (VDD), D14.1 (VDD), D15.1 (VDD), D16.1 (VDD), D17.1 (VDD), D18.1 (VDD), D19.1 (VDD), D20.1 (VDD); also elsewhere on the board
/LED indicators/DOUT: D20.2 (DOUT); also elsewhere on the board
/RGB_LED_DIN: D5.4 (DIN); also elsewhere on the board
GND: C117.1, C118.1, C119.1, C120.1, C121.1, C122.1, C123.1, C124.1, C125.1, C126.1, C127.1, C128.1, C129.1, C130.1, C131.1, C132.1, D5.3 (VSS), D6.3 (VSS), D7.3 (VSS), D8.3 (VSS), D9.3 (VSS), D10.3 (VSS), D11.3 (VSS), D12.3 (VSS), D13.3 (VSS), D14.3 (VSS), D15.3 (VSS), D16.3 (VSS), D17.3 (VSS), D18.3 (VSS), D19.3 (VSS), D20.3 (VSS); also elsewhere on the board
unnamed: D5.2 (DOUT), D6.4 (DIN)
unnamed: D6.2 (DOUT), D7.4 (DIN)
unnamed: D7.2 (DOUT), D8.4 (DIN)
unnamed: D8.2 (DOUT), D9.4 (DIN)
unnamed: D10.2 (DOUT), D11.4 (DIN)
unnamed: D9.2 (DOUT), D10.4 (DIN)
unnamed: D11.2 (DOUT), D12.4 (DIN)
unnamed: D12.2 (DOUT), D13.4 (DIN)
unnamed: D13.2 (DOUT), D14.4 (DIN)
unnamed: D14.2 (DOUT), D15.4 (DIN)
unnamed: D15.2 (DOUT), D16.4 (DIN)
unnamed: D16.2 (DOUT), D17.4 (DIN)
unnamed: D17.2 (DOUT), D18.4 (DIN)
unnamed: D19.2 (DOUT), D20.4 (DIN)
unnamed: D18.2 (DOUT), D19.4 (DIN)

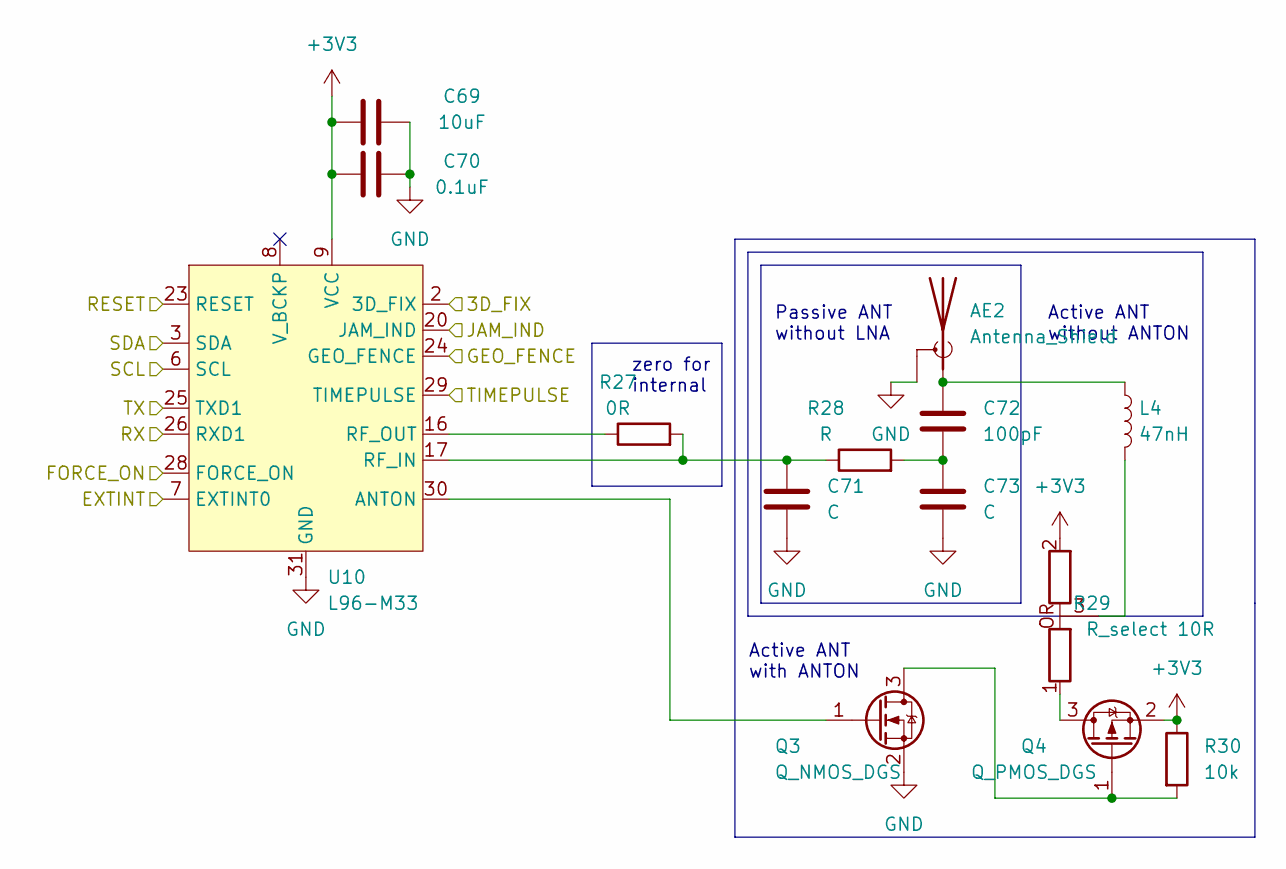
[picture p8: schematic GPS.kicad_sch]

Parts:
AE2: Antenna_Shield; U.FL_Molex_MCRF_73412-0110_Vertical
C69: 10uF; C_1206_3216Metric_Pad1.33x1.80mm_HandSolder
C70: 0.1uF; C_0603_1608Metric_Pad1.08x0.95mm_HandSolder
C71, C73: C; C_0603_1608Metric_Pad1.08x0.95mm_HandSolder
C72: 100pF; C_0603_1608Metric_Pad1.08x0.95mm_HandSolder
L4: 47nH; L_0603_1608Metric_Pad1.05x0.95mm_HandSolder
Q3: Q_NMOS_DGS; SOT-23
Q4: Q_PMOS_DGS; SOT-23
R27: 0R; R_0603_1608Metric_Pad0.98x0.95mm_HandSolder
R28: R; R_0603_1608Metric_Pad0.98x0.95mm_HandSolder
R29: R_select 10R; 0603-R-select
R30: 10k; R_0603_1608Metric_Pad0.98x0.95mm_HandSolder
U10: L96-M33; L96

Connections:
+3V3: C69.2, C70.2, Q4.2 (S), R29.2, R30.1, U10.9 (VCC); also elsewhere on the board
/GPS/EXTINT: U10.7 (EXTINT0); also elsewhere on the board
/GPS/FORCE_ON: U10.28 (FORCE_ON); also elsewhere on the board
/GPS_3D_FIX: U10.2 (3D_FIX); also elsewhere on the board
/GPS_GEO_FENCE: U10.24 (GEO_FENCE); also elsewhere on the board
/GPS_JAM_IND: U10.20 (JAM_IND); also elsewhere on the board
/GPS_RESET: U10.23 (RESET); also elsewhere on the board
/GPS_TIMEPULSE: U10.29 (TIMEPULSE); also elsewhere on the board
/MCU_I2C_SCL: U10.6 (SCL); also elsewhere on the board
/MCU_I2C_SDA: U10.3 (SDA); also elsewhere on the board
/MCU_U1RXD: U10.25 (TXD1); also elsewhere on the board
/MCU_U1TXD: U10.26 (RXD1); also elsewhere on the board
GND: AE2.2 (Shield), C69.1, C70.1, C71.2, C73.2, Q3.2 (S), U10.4 (GND), U10.5 (GND), U10.10 (GND), U10.11 (GND), U10.12 (GND), U10.13 (GND), U10.14 (GND), U10.15 (GND), U10.18 (GND), U10.19 (GND), U10.21 (GND), U10.22 (GND), U10.27 (GND), U10.31 (GND); also elsewhere on the board
unnamed: AE2.1 (A), C72.2, L4.1
unnamed: C71.1, R27.2, R28.1, U10.17 (RF_IN)
unnamed: C72.1, C73.1, R28.2
unnamed: L4.2, R29.3
unnamed: Q3.1 (G), U10.30 (ANTON)
unnamed: Q3.3 (D), Q4.1 (G), R30.2
unnamed: Q4.3 (D), R29.1
unnamed: R27.1, U10.16 (RF_OUT)

Notes on the sheet:
Active ANT with ANTON
zero for internal
Active ANT without ANTON
Passive ANT without LNA
