jakoai/Riistvara-projekt/airsoft_controller.kicad_pcb

## KiCad design airsoft_controller.kicad_pcb (continued)

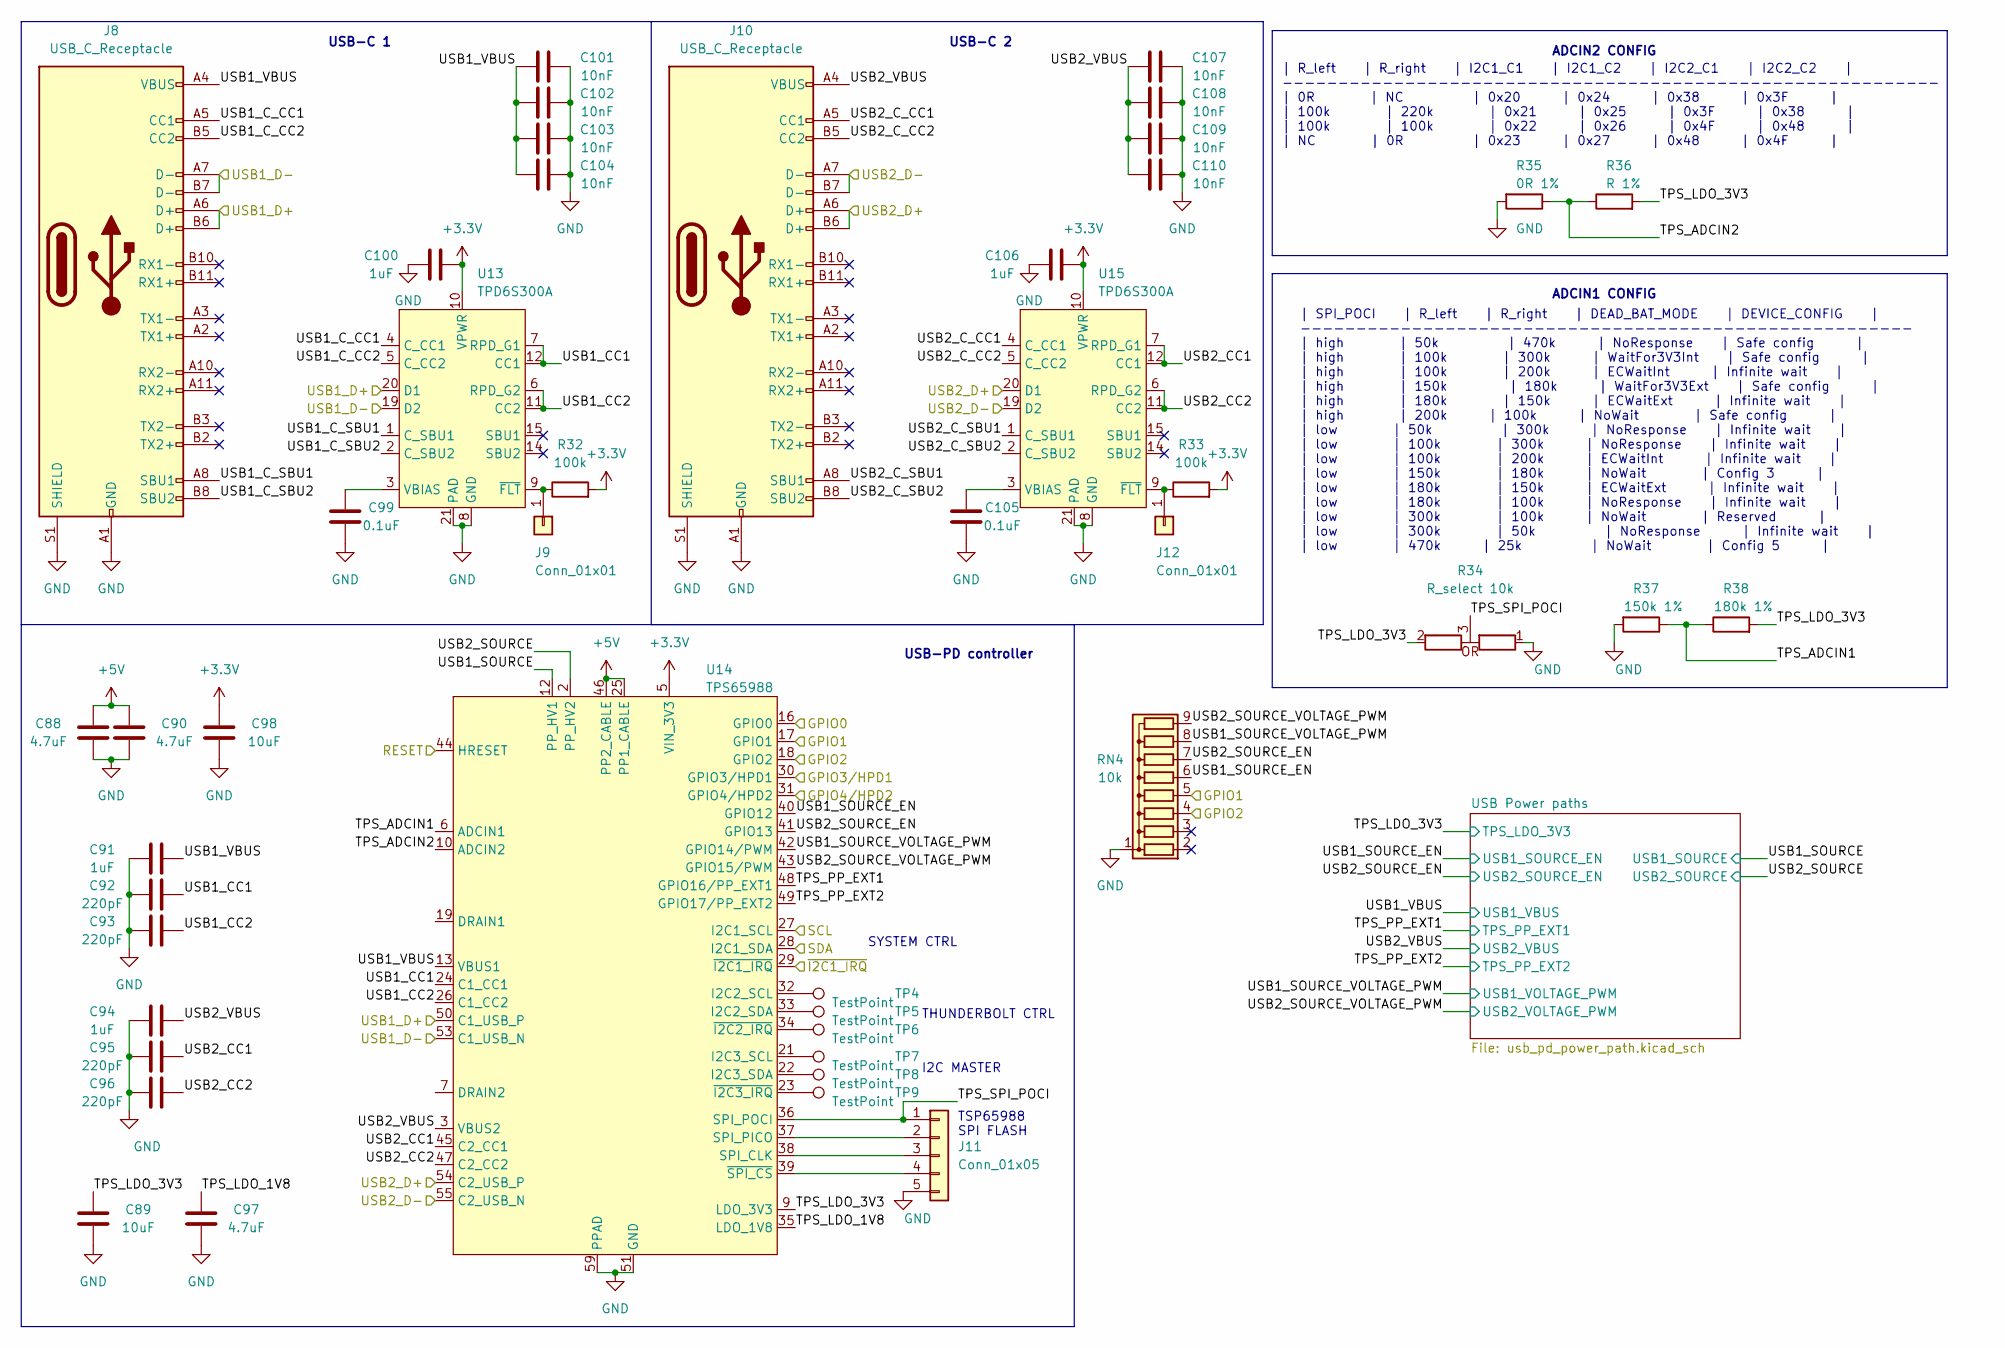
[picture p9: schematic TPS65988.kicad_sch]

Parts:
C88, C90, C97: 4.7uF; C_0603_1608Metric_Pad1.08x0.95mm_HandSolder
C89, C98: 10uF; C_0805_2012Metric_Pad1.18x1.45mm_HandSolder
C91, C94, C100, C106: 1uF; C_0603_1608Metric_Pad1.08x0.95mm_HandSolder
C92, C93, C95, C96: 220pF; C_0603_1608Metric_Pad1.08x0.95mm_HandSolder
C99, C105: 0.1uF; C_0603_1608Metric_Pad1.08x0.95mm_HandSolder
C101, C102, C103, C104, C107, C108, C109, C110: 10nF; C_0603_1608Metric_Pad1.08x0.95mm_HandSolder
J8, J10: USB_C_Receptacle; USB-C-2305018-2
J9, J12: Conn_01x01; PinSocket_1x01_P2.54mm_Vertical
J11: Conn_01x05; PinSocket_1x05_P2.54mm_Vertical
R32, R33: 100k; R_0603_1608Metric_Pad0.98x0.95mm_HandSolder
R34: R_select 10k; 0603-R-select
R35: 0R 1%; R_0603_1608Metric_Pad0.98x0.95mm_HandSolder
R36: R 1%; R_0603_1608Metric_Pad0.98x0.95mm_HandSolder
R37: 150k 1%; R_0603_1608Metric_Pad0.98x0.95mm_HandSolder
R38: 180k 1%; R_0603_1608Metric_Pad0.98x0.95mm_HandSolder
RN4: 10k; R_Array_SIP9
TP4, TP5, TP6, TP7, TP8, TP9: TestPoint; TestPoint_Pad_D1.5mm
U13, U15: TPD6S300A; WQFN-20-1EP_3x3mm_P0.4mm_EP1.7x1.7mm
U14: TPS65988; VQFN-56-3EP

Connections:
+5V: C88.2, C90.2, U14.25 (PP1_CABLE), U14.46 (PP2_CABLE); also elsewhere on the board
/BATTERY_BALANCE_EN: RN4.5 (R4), U14.17 (GPIO1); also elsewhere on the board
/BATTERY_MGMT_OTG: RN4.4 (R3), U14.18 (GPIO2); also elsewhere on the board
/CP2102_USB_D+: J10.A6 (D+), J10.B6 (D+), U14.54 (C2_USB_P), U15.20 (D1); also elsewhere on the board
/CP2102_USB_D-: J10.A7 (D-), J10.B7 (D-), U14.55 (C2_USB_N), U15.19 (D2); also elsewhere on the board
/MCU_I2C_SCL: U14.27 (I2C1_SCL); also elsewhere on the board
/MCU_I2C_SDA: U14.28 (I2C1_SDA); also elsewhere on the board
/MCU_USB_D+: J8.A6 (D+), J8.B6 (D+), U13.20 (D1), U14.50 (C1_USB_P); also elsewhere on the board
/MCU_USB_D-: J8.A7 (D-), J8.B7 (D-), U13.19 (D2), U14.53 (C1_USB_N); also elsewhere on the board
/USB-C power controller/GPIO0: U14.16 (GPIO0); also elsewhere on the board
/USB-C power controller/GPIO3/HPD1: U14.30 (GPIO3/HPD1); also elsewhere on the board
/USB-C power controller/GPIO4/HPD2: U14.31 (GPIO4/HPD2); also elsewhere on the board
/USB-C power controller/TPS_ADCIN1: R37.1, R38.1, U14.6 (ADCIN1)
/USB-C power controller/TPS_ADCIN2: R35.1, R36.1, U14.10 (ADCIN2)
/USB-C power controller/TPS_LDO_1V8: C97.2, U14.35 (LDO_1V8)
/USB-C power controller/TPS_LDO_3V3: C89.2, R34.2, R36.2, R38.2, U14.9 (LDO_3V3); also elsewhere on the board
/USB-C power controller/TPS_PP_EXT1: U14.48 (GPIO16/PP_EXT1); also elsewhere on the board
/USB-C power controller/TPS_PP_EXT2: U14.49 (GPIO17/PP_EXT2); also elsewhere on the board
/USB-C power controller/TPS_SPI_POCI: J11.1, R34.3, U14.36 (SPI_POCI)
/USB-C power controller/USB1_CC1: C92.1, U13.7 (RPD_G1), U13.12 (CC1), U14.24 (C1_CC1)
/USB-C power controller/USB1_CC2: C93.1, U13.6 (RPD_G2), U13.11 (CC2), U14.26 (C1_CC2)
/USB-C power controller/USB1_C_CC1: J8.A5 (CC1), U13.4 (C_CC1)
/USB-C power controller/USB1_C_CC2: J8.B5 (CC2), U13.5 (C_CC2)
/USB-C power controller/USB1_C_SBU1: J8.A8 (SBU1), U13.1 (C_SBU1)
/USB-C power controller/USB1_C_SBU2: J8.B8 (SBU2), U13.2 (C_SBU2)
/USB-C power controller/USB1_SOURCE: U14.11 (PP_HV1), U14.12 (PP_HV1); also elsewhere on the board
/USB-C power controller/USB1_SOURCE_EN: RN4.6 (R5), U14.40 (GPIO12); also elsewhere on the board
/USB-C power controller/USB1_SOURCE_VOLTAGE_PWM: RN4.8 (R7), U14.42 (GPIO14/PWM); also elsewhere on the board
/USB-C power controller/USB1_VBUS: C91.1, C101.1, C102.1, C103.1, C104.1, J8.A4 (VBUS), J8.A9 (VBUS), J8.B4 (VBUS), J8.B9 (VBUS), U14.13 (VBUS1), U14.14 (VBUS1); also elsewhere on the board
/USB-C power controller/USB2_CC1: C95.1, U14.45 (C2_CC1), U15.7 (RPD_G1), U15.12 (CC1)
/USB-C power controller/USB2_CC2: C96.1, U14.47 (C2_CC2), U15.6 (RPD_G2), U15.11 (CC2)
/USB-C power controller/USB2_C_CC1: J10.A5 (CC1), U15.4 (C_CC1)
/USB-C power controller/USB2_C_CC2: J10.B5 (CC2), U15.5 (C_CC2)
/USB-C power controller/USB2_C_SBU1: J10.A8 (SBU1), U15.1 (C_SBU1)
/USB-C power controller/USB2_C_SBU2: J10.B8 (SBU2), U15.2 (C_SBU2)
/USB-C power controller/USB2_SOURCE: U14.1 (PP_HV2), U14.2 (PP_HV2); also elsewhere on the board
/USB-C power controller/USB2_SOURCE_EN: RN4.7 (R6), U14.41 (GPIO13); also elsewhere on the board
/USB-C power controller/USB2_SOURCE_VOLTAGE_PWM: RN4.9 (R8), U14.43 (GPIO15/PWM); also elsewhere on the board
/USB-C power controller/USB2_VBUS: C94.1, C107.1, C108.1, C109.1, C110.1, J10.A4 (VBUS), J10.A9 (VBUS), J10.B4 (VBUS), J10.B9 (VBUS), U14.3 (VBUS2), U14.4 (VBUS2); also elsewhere on the board
/USB_PD_CNTR_RESET: U14.44 (HRESET); also elsewhere on the board
/USB_PD_I2C1_IRQ: U14.29 (~I2C1_IRQ); also elsewhere on the board
GND: C88.1, C89.1, C90.1, C91.2, C92.2, C93.2, C94.2, C95.2, C96.2, C97.1, C98.1, C99.1, C100.1, C101.2, C102.2, C103.2, C104.2, C105.1, C106.1, C107.2, C108.2, C109.2, C110.2, J8.A1 (GND), J8.A12 (GND), J8.B1 (GND), J8.B12 (GND), J8.S1 (SHIELD), J10.A1 (GND), J10.A12 (GND), J10.B1 (GND), J10.B12 (GND), J10.S1 (SHIELD), J11.5, R34.1, R35.2, R37.2, RN4.1 (common), U13.8 (GND), U13.13 (GND), U13.18 (GND), U13.21 (PAD), U14.20 (GND), U14.51 (GND), U14.59 (PPAD), U15.8 (GND), U15.13 (GND), U15.18 (GND), U15.21 (PAD); also elsewhere on the board
unnamed: C99.2, U13.3 (VBIAS)
unnamed: C105.2, U15.3 (VBIAS)
unnamed: J9.1, R32.1, U13.9 (~FLT)
unnamed: J11.2, U14.37 (SPI_PICO)
unnamed: J11.3, U14.38 (SPI_CLK)
unnamed: J11.4, U14.39 (~SPI_CS)
unnamed: J12.1, R33.1, U15.9 (~FLT)
unnamed: U14.8 (DRAIN1), U14.15 (DRAIN1), U14.19 (DRAIN1), U14.58 (DRAIN1)
unnamed: TP7.1, U14.21 (I2C3_SCL)
unnamed: TP8.1, U14.22 (I2C3_SDA)
unnamed: TP9.1, U14.23 (~I2C3_IRQ)
unnamed: TP4.1, U14.32 (I2C2_SCL)
unnamed: TP5.1, U14.33 (I2C2_SDA)
unnamed: TP6.1, U14.34 (~I2C2_IRQ)
unnamed: U14.7 (DRAIN2), U14.52 (DRAIN2), U14.56 (DRAIN2), U14.57 (DRAIN2)

Notes on the sheet:
THUNDERBOLT CTRL
TSP65988 SPI FLASH
USB-PD controller
| SPI_POCI | R_left | R_right | DEAD_BAT_MODE | DEVICE_CONFIG | ------------------------------------------------------- | high | 50k | 470k | NoResponse | Safe config | | high | 100k | 300k | WaitFor3V3Int | Safe config | | high | 100k | 200k | ECWaitInt | Infinite wait | | high | 150k | 180k | Wai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
I2C MASTER
| R_left | R_right | I2C1_C1 | I2C1_C2 | I2C2_C1 | I2C2_C2 | ----------------------------------------------------------- | 0R | NC | 0x20 | 0x24 | 0x38 | 0x3F | | 100k | 220k | 0x21 | 0x25 | 0x3F | 0x38 | | 100k | 100k | 0x22 | 0x26 | 0x4F | 0x48 | | NC | 0R | 0x23 | 0x27 | 0x48 | 0x4F |
USB-C 2
SYSTEM CTRL
ADCIN2 CONFIG
ADCIN1 CONFIG
USB-C 1

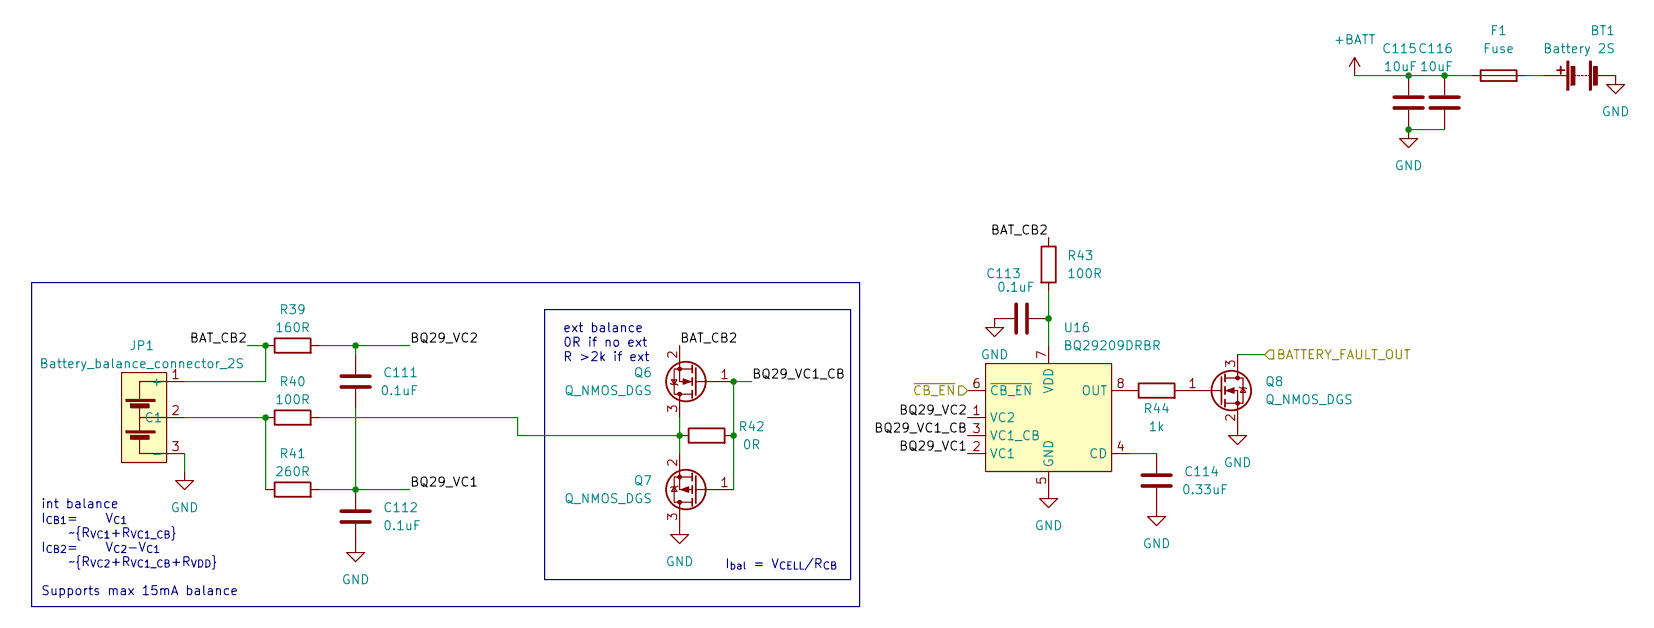
[picture p10: schematic bat_protect.kicad_sch]

Parts:
BT1: Battery 2S; BAT_CONN_5mm_pitch
C111, C112, C113: 0.1uF; C_0603_1608Metric_Pad1.08x0.95mm_HandSolder
C114: 0.33uF; C_0603_1608Metric_Pad1.08x0.95mm_HandSolder
C115, C116: 10uF; C_1206_3216Metric_Pad1.33x1.80mm_HandSolder
F1: Fuse; fuse_clip_5x20-33mm
JP1: Battery_balance_connector_2S; JST_XH_3P-Horizontal
Q6, Q7, Q8: Q_NMOS_DGS; SOT-23
R39: 160R; R_0603_1608Metric_Pad0.98x0.95mm_HandSolder
R40, R43: 100R; R_Box_L13.0mm_W4.0mm_P9.00mm
R41: 260R; R_0603_1608Metric_Pad0.98x0.95mm_HandSolder
R42: 0R; R_0603_1608Metric_Pad0.98x0.95mm_HandSolder
R44: 1k; R_0603_1608Metric_Pad0.98x0.95mm_HandSolder
U16: BQ29209DRBR; VSON-8

Connections:
+BATT: C115.2, C116.2, F1.1; also elsewhere on the board
/BATTERY_BALANCE_EN: U16.6 (~CB_EN); also elsewhere on the board
/BATTERY_FAULT: Q8.3 (D); also elsewhere on the board
/Battery manager/Battery protection/BAT_CB2: JP1.1 (+), Q6.2 (S), R39.1, R43.1
/Battery manager/Battery protection/BQ29_VC1: C111.1, C112.1, R41.2, U16.2 (VC1)
/Battery manager/Battery protection/BQ29_VC1_CB: Q6.1 (G), Q7.1 (G), R42.2, U16.3 (VC1_CB)
/Battery manager/Battery protection/BQ29_VC2: C111.2, R39.2, U16.1 (VC2)
GND: BT1.2 (-), C112.2, C113.2, C114.1, C115.1, C116.1, JP1.3 (-), Q7.3 (D), Q8.2 (S), U16.5 (GND), U16.PAD (GND); also elsewhere on the board
unnamed: BT1.1 (+), F1.2
unnamed: C113.1, R43.2, U16.7 (VDD)
unnamed: C114.2, U16.4 (CD)
unnamed: JP1.2 (C1), R40.1, R41.1
unnamed: Q6.3 (D), Q7.2 (S), R40.2, R42.1
unnamed: Q8.1 (G), R44.2
unnamed: R44.1, U16.8 (OUT)

Notes on the sheet:
ext balance 0R if no ext R >2k if ext
I_{bal} = V_{CELL}/R_{CB}
int balance I_{CB1}= V_{C1} ~{R_{VC1}+R_{VC1_CB}} I_{CB2}= V_{C2}-V_{C1} ~{R_{VC2}+R_{VC1_CB}+R_{VDD}} Supports max 15mA balance

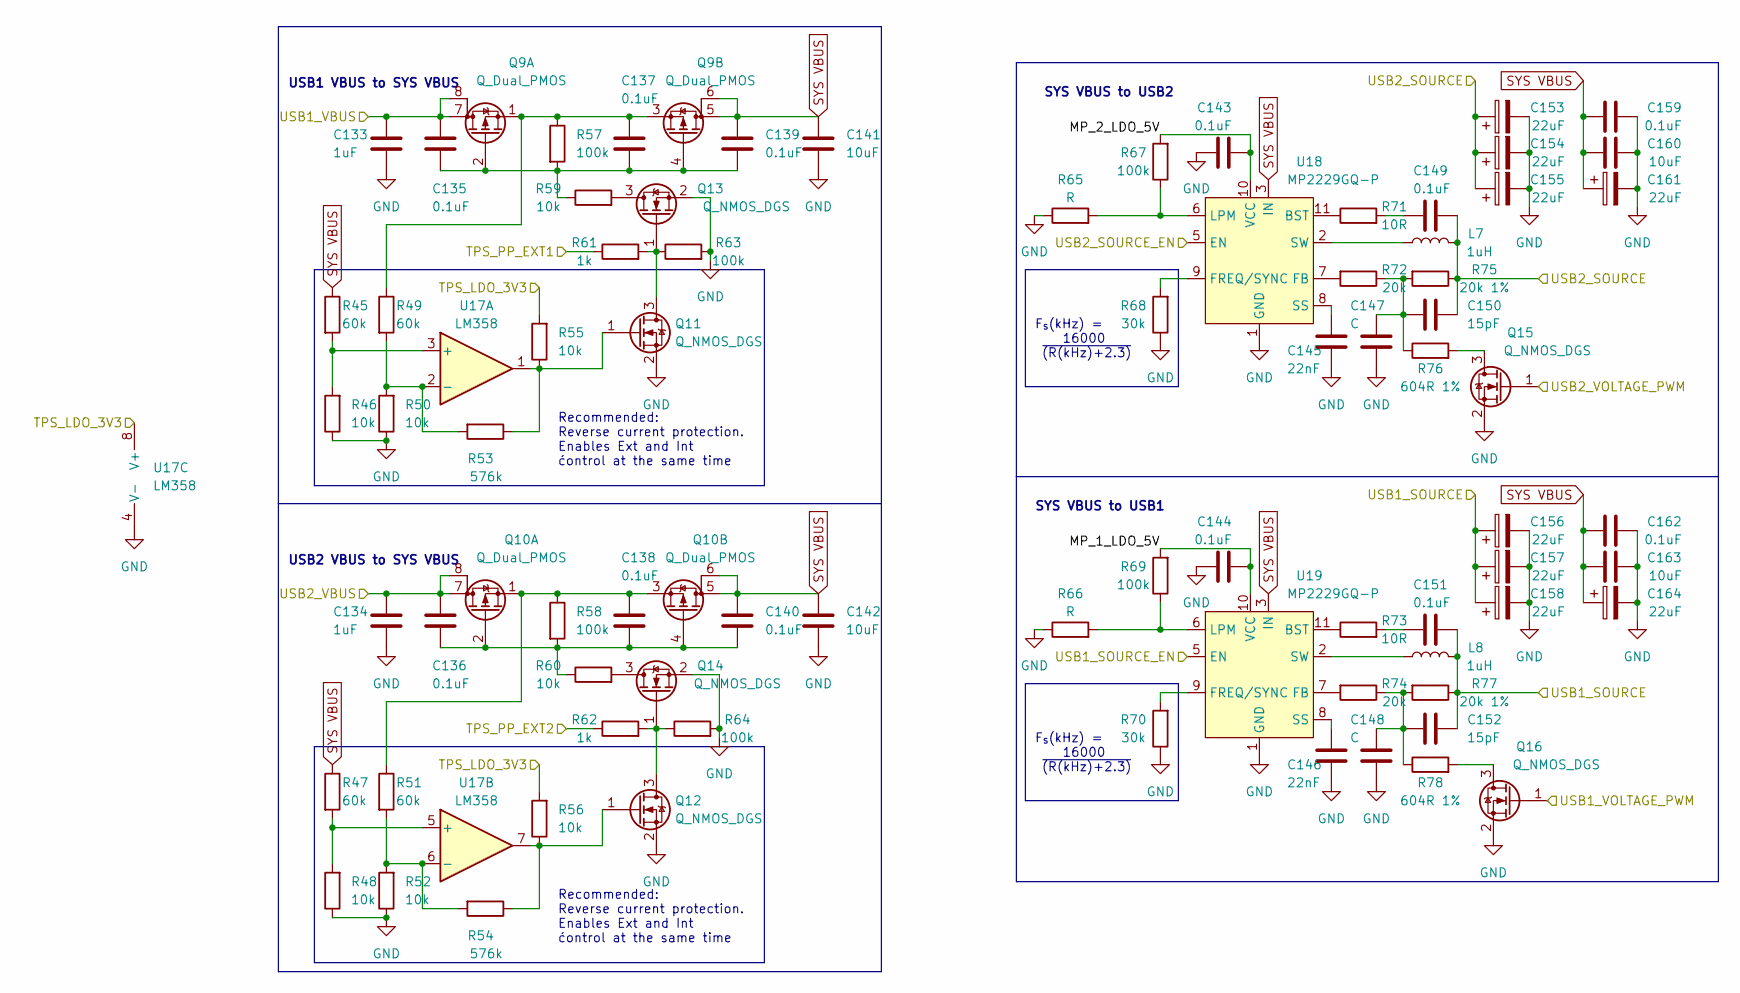
[picture p11: schematic usb_pd_power_path.kicad_sch]

Parts:
C133, C134: 1uF; C_0603_1608Metric_Pad1.08x0.95mm_HandSolder
C135, C136, C137, C138, C139, C140, C143, C144, C149, C151, C159, C162: 0.1uF; C_0603_1608Metric_Pad1.08x0.95mm_HandSolder
C141, C142, C160, C163: 10uF; C_0805_2012Metric_Pad1.18x1.45mm_HandSolder
C145, C146: 22nF; C_0603_1608Metric_Pad1.08x0.95mm_HandSolder
C147, C148: C; C_0603_1608Metric_Pad1.08x0.95mm_HandSolder
C150, C152: 15pF; C_0603_1608Metric_Pad1.08x0.95mm_HandSolder
C153, C154, C155, C156, C157, C158, C161, C164: 22uF; CP_Elec_5x5.3
L7, L8: 1uH; Inductor_8030
Q9, Q10: Q_Dual_PMOS; SO-8_3.9x4.9mm_P1.27mm
Q11, Q12, Q13, Q14, Q15, Q16: Q_NMOS_DGS; SOT-23
R45, R47, R49, R51: 60k; R_0603_1608Metric_Pad0.98x0.95mm_HandSolder
R46, R48, R50, R52, R55, R56, R59, R60: 10k; R_0603_1608Metric_Pad0.98x0.95mm_HandSolder
R53, R54: 576k; R_0603_1608Metric_Pad0.98x0.95mm_HandSolder
R57, R58, R63, R64, R67, R69: 100k; R_0603_1608Metric_Pad0.98x0.95mm_HandSolder
R61, R62: 1k; R_0603_1608Metric_Pad0.98x0.95mm_HandSolder
R65, R66: R; R_0603_1608Metric_Pad0.98x0.95mm_HandSolder
R68, R70: 30k; R_0603_1608Metric_Pad0.98x0.95mm_HandSolder
R71, R73: 10R; R_0603_1608Metric_Pad0.98x0.95mm_HandSolder
R72, R74: 20k; R_0603_1608Metric_Pad0.98x0.95mm_HandSolder
R75, R77: 20k 1%; R_0603_1608Metric_Pad0.98x0.95mm_HandSolder
R76, R78: 604R 1%; R_0603_1608Metric_Pad0.98x0.95mm_HandSolder
U17: LM358; SOIC-8_3.9x4.9mm_P1.27mm
U18, U19: MP2229GQ-P; QFN-14

Connections:
/USB-C power controller/TPS_LDO_3V3: R55.2, R56.2, U17.8 (V+); also elsewhere on the board
/USB-C power controller/TPS_PP_EXT1: R61.1; also elsewhere on the board
/USB-C power controller/TPS_PP_EXT2: R62.1; also elsewhere on the board
/USB-C power controller/USB1_SOURCE: C151.1, C152.1, C156.1, C157.1, C158.1, L8.2, R77.1; also elsewhere on the board
/USB-C power controller/USB1_SOURCE_EN: U19.5 (EN); also elsewhere on the board
/USB-C power controller/USB1_SOURCE_VOLTAGE_PWM: Q16.1 (G); also elsewhere on the board
/USB-C power controller/USB1_VBUS: C133.1, C135.1, Q9.7 (D), Q9.8 (G); also elsewhere on the board
/USB-C power controller/USB2_SOURCE: C149.1, C150.1, C153.1, C154.1, C155.1, L7.2, R75.1; also elsewhere on the board
/USB-C power controller/USB2_SOURCE_EN: U18.5 (EN); also elsewhere on the board
/USB-C power controller/USB2_SOURCE_VOLTAGE_PWM: Q15.1 (G); also elsewhere on the board
/USB-C power controller/USB2_VBUS: C134.1, C136.1, Q10.7 (D), Q10.8 (G); also elsewhere on the board
/USB-C power controller/USB Power paths/MP_1_LDO_5V: C144.2, R69.2, U19.10 (VCC)
/USB-C power controller/USB Power paths/MP_2_LDO_5V: C143.2, R67.2, U18.10 (VCC)
GND: C133.2, C134.2, C141.2, C142.2, C143.1, C144.1, C145.2, C146.2, C147.2, C148.2, C153.2, C154.2, C155.2, C156.2, C157.2, C158.2, C159.2, C160.2, C161.2, C162.2, C163.2, C164.2, Q11.2 (S), Q12.2 (S), Q13.2 (S), Q14.2 (S), Q15.2 (S), Q16.2 (S), R46.1, R48.1, R50.1, R52.1, R63.2, R64.2, R65.1, R66.1, R68.1, R70.1, U17.4 (V-), U18.1 (GND), U18.12 (GND), U18.13 (GND), U18.14 (GND), U19.1 (GND), U19.12 (GND), U19.13 (GND), U19.14 (GND); also elsewhere on the board
unnamed: C135.2, C137.2, C139.2, Q9.2 (G), Q9.4 (G), R57.2, R59.1
unnamed: C136.2, C138.2, C140.2, Q10.2 (G), Q10.4 (G), R58.2, R60.1
unnamed: C137.1, Q9.1 (S), Q9.3 (S), R49.1, R57.1
unnamed: C138.1, Q10.1 (S), Q10.3 (S), R51.1, R58.1
unnamed: C145.1, U18.8 (SS)
unnamed: C146.1, U19.8 (SS)
unnamed: C147.1, C150.2, R72.1, R75.2, R76.1
unnamed: C148.1, C152.2, R74.1, R77.2, R78.1
unnamed: C149.2, R71.2
unnamed: C151.2, R73.2
unnamed: L7.1, U18.2 (SW), U18.4 (SW)
unnamed: L8.1, U19.2 (SW), U19.4 (SW)
unnamed: Q11.1 (G), R53.1, R55.1, U17.1
unnamed: Q11.3 (D), Q13.1 (G), R61.2, R63.1
unnamed: Q12.1 (G), R54.1, R56.1, U17.7
unnamed: Q12.3 (D), Q14.1 (G), R62.2, R64.1
unnamed: Q13.3 (D), R59.2
unnamed: Q14.3 (D), R60.2
unnamed: Q15.3 (D), R76.2
unnamed: Q16.3 (D), R78.2
unnamed: R45.2, R46.2, U17.3 (+)
unnamed: R47.2, R48.2, U17.5 (+)
unnamed: R49.2, R50.2, R53.2, U17.2 (-)
unnamed: R51.2, R52.2, R54.2, U17.6 (-)
unnamed: R65.2, R67.1, U18.6 (LPM)
unnamed: R66.2, R69.1, U19.6 (LPM)
unnamed: R68.2, U18.9 (FREQ/SYNC)
unnamed: R70.2, U19.9 (FREQ/SYNC)
unnamed: R71.1, U18.11 (BST)
unnamed: R72.2, U18.7 (FB)
unnamed: R73.1, U19.11 (BST)
unnamed: R74.2, U19.7 (FB)
SYS VBUS: C139.1, C140.1, C141.1, C142.1, C159.1, C160.1, C161.1, C162.1, C163.1, C164.1, Q9.5 (D), Q9.6 (G), Q10.5 (D), Q10.6 (G), R45.1, R47.1, U18.3 (IN), U18.15 (IN), U19.3 (IN), U19.15 (IN); also elsewhere on the board

Notes on the sheet:
F_{s}(kHz) = 16000 ~{(R(kHz)+2.3)}
USB1 VBUS to SYS VBUS
Recommended: Reverse current protection. Enables Ext and Int ćontrol at the same time
SYS VBUS to USB2
USB2 VBUS to SYS VBUS
SYS VBUS to USB1

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
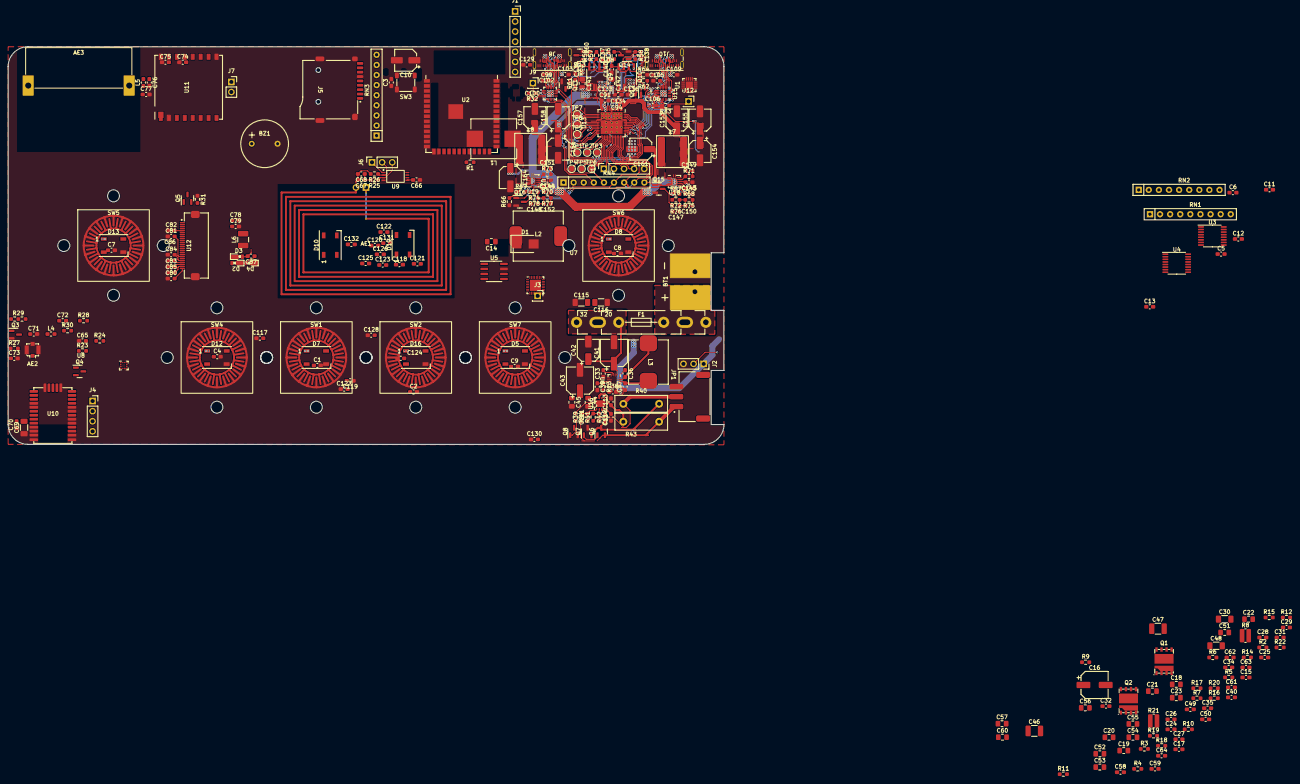
[picture p12: board airsoft_controller.kicad_pcb from above]

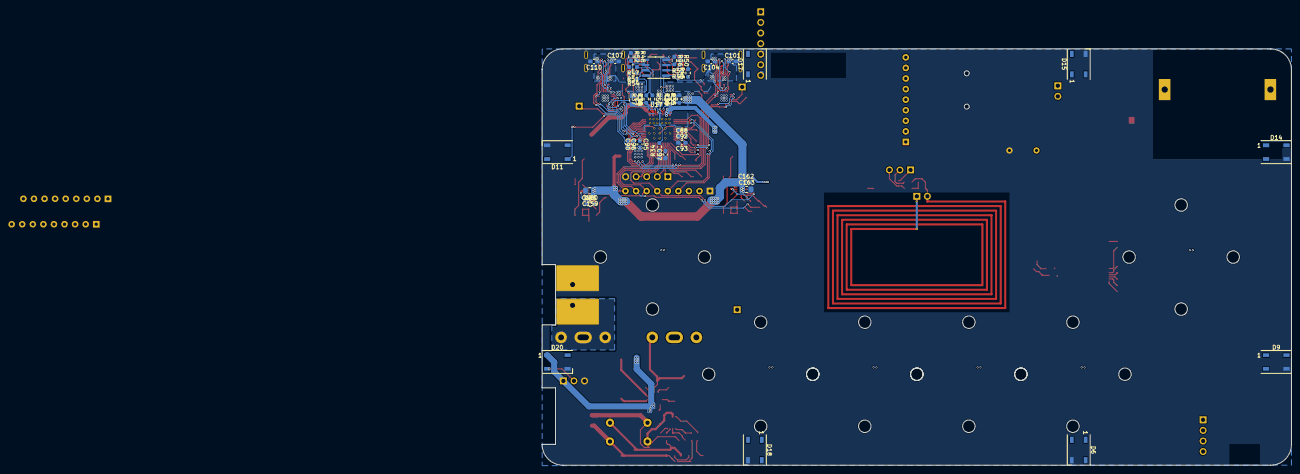
[picture p13: board airsoft_controller.kicad_pcb from below]

Board: 2 copper layers, 180.0 x 100.0 mm, 344 parts (44 on the bottom side), 253 nets.
