jakoai/Riistvara-projekt/(commit log)

2022-10-03 initial commit, IMU ESP and USB-PD symbols
    [airsoft_controller.kicad_pcb, airsoft_controller.kicad_sch, usb_pd.kicad_sch]
2022-10-05 added lora, gps, nfc schematics
    [GPS.kicad_sch, NFC.kicad_sch, airsoft_controller.kicad_sch, imu.kicad_sch, usb_pd.kicad_sch]
2022-10-08 Added display, update lora sym, updated usb-pd schematic, connected sd, added external buttons
    [airsoft_controller.kicad_sch, components.xlsx, display.kicad_sch, imu.kicad_sch, lora.kicad_sch, usb_pd.kicad_sch]
2022-10-11 Added new lora, added rgb leds, updated TSP65988 schematic, added bat to 3v3, added battery balancer
    [NFC.kicad_sch, TPS65988.kicad_sch, airsoft_controller.kicad_sch, bat_protect.kicad_sch, components.xlsx, lora.kicad_sch, rgb_leds.kicad_sch, usb_pd.kicad_sch]
2022-10-17 added digi-pote symbol, added USB_source voltage regulators
    [GPS.kicad_sch, NFC.kicad_sch, TPS65988.kicad_sch, airsoft_controller.kicad_sch, bat_protect.kicad_sch, components.xlsx, display.kicad_sch, imu.kicad_sch]
2022-10-19 added audio ref schematic, added bat to 5V, added shift register, connected devices with other periferals
    [GPS.kicad_sch, NFC.kicad_sch, TPS65988.kicad_sch, airsoft_controller.kicad_sch, audio.kicad_sch, bat_protect.kicad_sch, components.xlsx, display.kicad_sch]
2022-10-19 added adcin2 config description, fixed some rule check errors
    [GPS.kicad_sch, NFC.kicad_sch, TPS65988.kicad_sch, airsoft_controller.kicad_sch, bat_protect.kicad_sch, components.xlsx, display.kicad_sch, imu.kicad_sch]
2022-10-20 added external connectors
    [TPS65988.kicad_sch, airsoft_controller.kicad_sch]
2022-10-21 minor optimized pinassignement, added capacitors, added connectors
    [GPS.kicad_sch, NFC.kicad_sch, TPS65988.kicad_sch, airsoft_controller.kicad_sch, bat_protect.kicad_sch, display.kicad_sch, imu.kicad_sch, lora.kicad_sch]
2022-10-22 PI LC lowpass filter, added CP2012 reset, added connectors
    [GPS.kicad_sch, NFC.kicad_sch, TPS65988.kicad_sch, airsoft_controller.kicad_sch, bat_protect.kicad_sch, display.kicad_sch, imu.kicad_sch, lora.kicad_sch]
2022-10-22 datasheet checkout, added couple of capacitors for usb-c, groupd some scheatics
    [GPS.kicad_sch, TPS65988.kicad_sch, airsoft_controller.kicad_sch, bat_protect.kicad_sch, display.kicad_sch, lora.kicad_sch, rgb_leds.kicad_sch, usb_pd_power_path.kicad_sch]
2022-10-25 added nfc antenna components, added most of footprints
    [GPS.kicad_sch, NFC.kicad_sch, TPS65988.kicad_sch, airsoft_controller.kicad_sch, bat_protect.kicad_sch, components.xlsx, display.kicad_sch, imu.kicad_sch]
2022-10-25 added inductors to component list
    [components.xlsx]
2022-11-04 schematic creation
    [GPS.kicad_sch, NFC.kicad_sch, TPS65988.kicad_sch, airsoft_controller.kicad_pcb, airsoft_controller.kicad_sch, bat_protect.kicad_sch, components.xlsx, display.kicad_sch]
2022-11-06 edited usb pcb part
    [TPS65988.kicad_sch, airsoft_controller.kicad_pcb, airsoft_controller.kicad_sch, usb_pd.kicad_sch]
2022-11-07 usb power source added, need to reassemble to 4-layers
    [TPS65988.kicad_sch, airsoft_controller.kicad_pcb, airsoft_controller.kicad_sch, bat_protect.kicad_sch, rgb_leds.kicad_sch, usb_pd.kicad_sch, usb_pd_power_path.kicad_sch]
2022-11-12 done first iteration of pcb routing, slikscreen still broken
    [GPS.kicad_sch, NFC.kicad_sch, TPS65988.kicad_sch, airsoft_controller.kicad_sch, bat_protect.kicad_sch, display.kicad_sch, imu.kicad_sch, lora.kicad_sch]
2022-11-12 removed silkscreen warning markers
2022-11-21 mounting holes, fixes silkscreen
    [GPS.kicad_sch, NFC.kicad_sch, TPS65988.kicad_sch, airsoft_controller.kicad_sch, bat_protect.kicad_sch, display.kicad_sch, imu.kicad_sch, mountholes.kicad_sch]
2022-11-23 copied own LED footprint, modified silkscreen, minor visual changes in schematics
    [TPS65988.kicad_sch, airsoft_controller.kicad_sch, bat_protect.kicad_sch, rgb_leds.kicad_sch, usb_pd.kicad_sch]
2022-11-24 minor changes
    [GPS.kicad_sch, usb_pd.kicad_sch]
2022-11-24 added more ground vias for specific components, fixed battery current schunt measurement trace start point, removed small groud plane next to LoRa antenna
    [usb_pd.kicad_sch]
2022-11-26 final pcb check and minor fixes
    [TPS65988.kicad_sch, bat_protect.kicad_sch, usb_pd.kicad_sch]
2023-01-03 minor setting changes in schematics, added test software container
    [airsoft_controller.kicad_sch, usb_pd.kicad_sch, usb_pd_power_path.kicad_sch]
